marcstaiger/FPGA_Signalgenerator/Dokumentation/01_titel.tex

\begin{titlepage}
\begin{center}
\begin{tabular}{p{\textwidth}}

\begin{center}
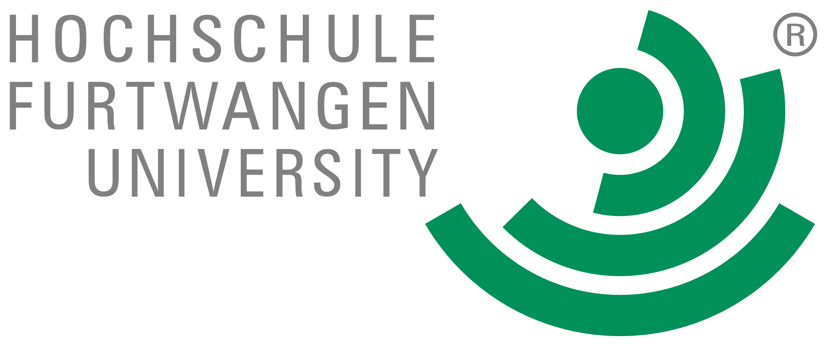
[picture p1: Dokumentation/Bilder/logo_hochschule.jpg]
    
\end{center}

\vspace{2cm}

\begin{center}
\LARGE{\textsc{
FPGA Praktikum \\
SoSe 26\\
\vspace{1cm}
 Aufgabe Signalgenerator
}}
\end{center}

\\

\begin{center}
\large{Fakultät 2 \\
der Hochschule Furtwangen }
\end{center}

\begin{center}
\large{im März 2026}
\end{center}

\\

\\
\
\begin{center}
\begin{tabular}{lll}
\textbf{Betreuer:} & & Prof. Dr. Richard Spiegelberg \\
\textbf{Autor:} & & Marc Staiger\\
\end{tabular}
\end{center}

\end{tabular}
\end{center}
\end{titlepage}
