marcstaiger/FPGA_Signalgenerator/Schaltplan.pdf

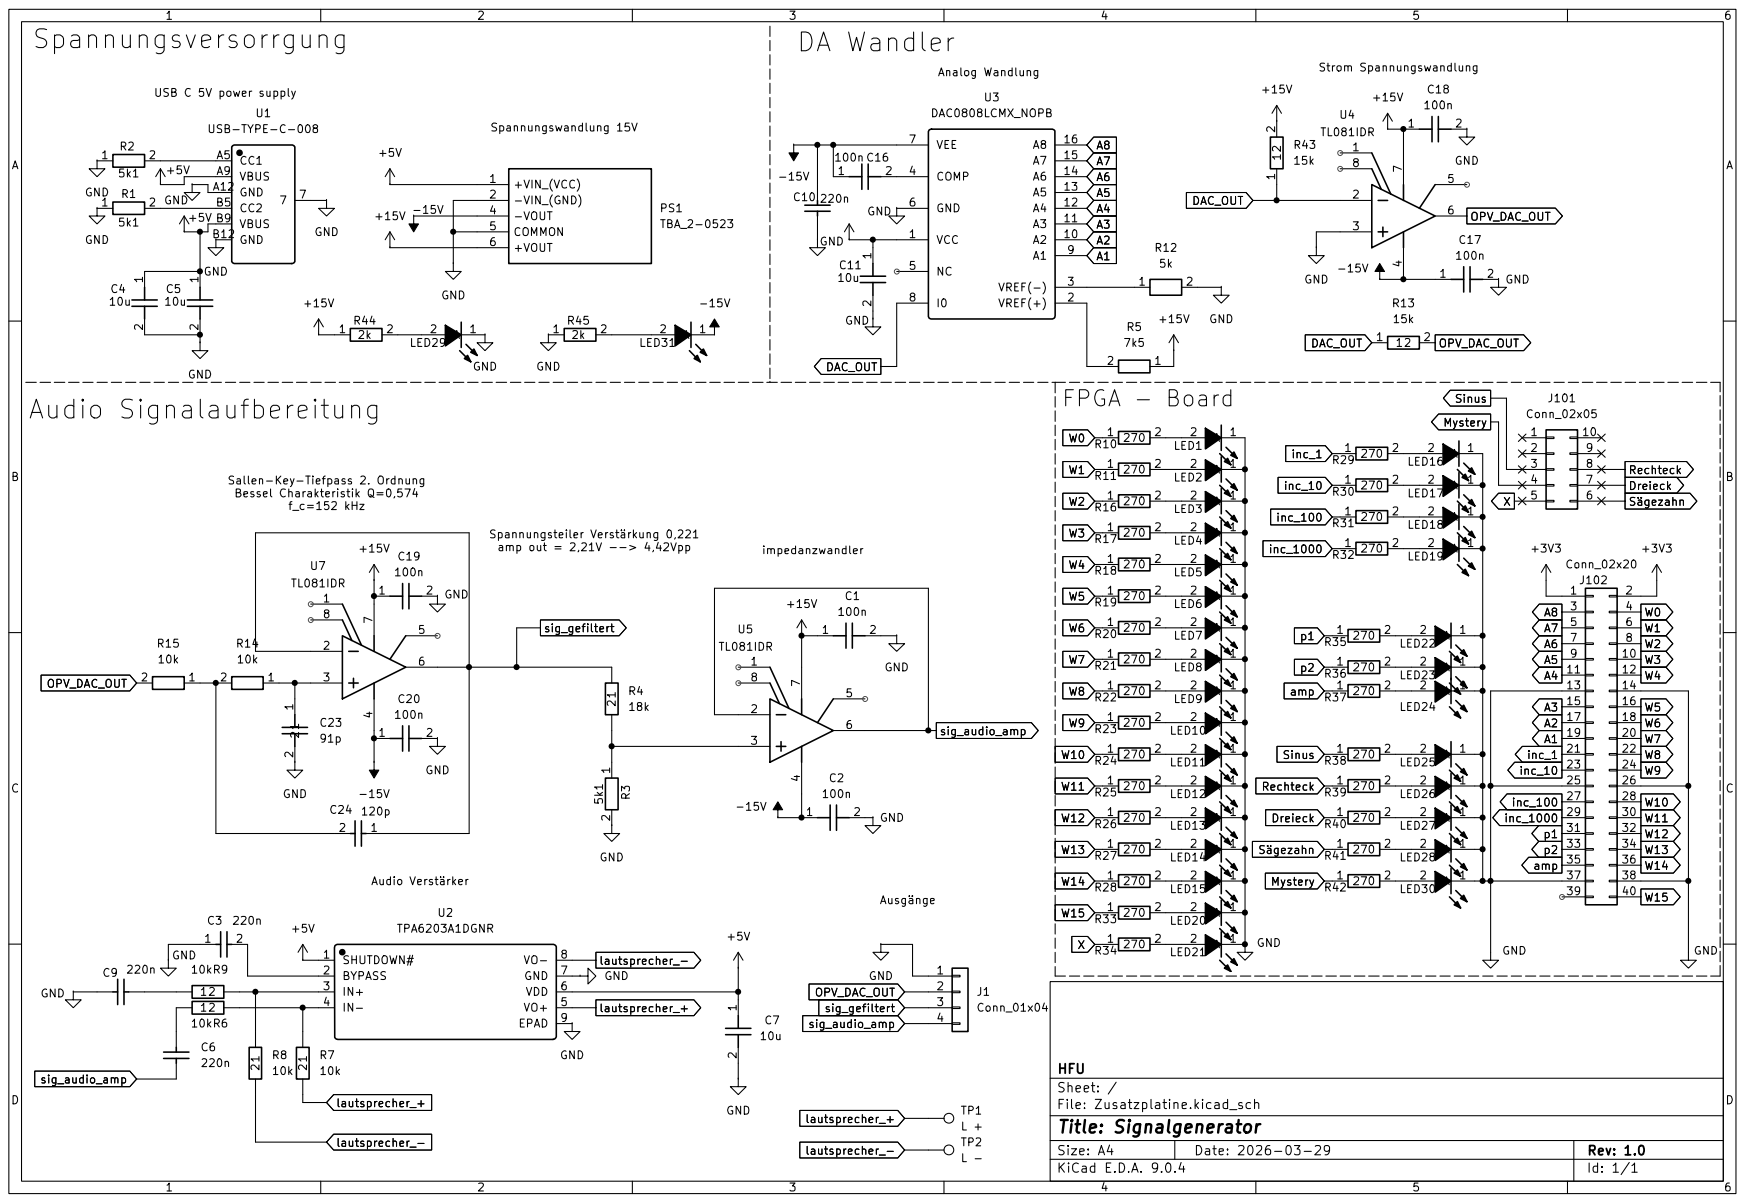
[picture p13: page 1]
