marcstaiger/FPGA_Signalgenerator/Platine/Platine.kicad_pcb

## KiCad design Platine/Platine.kicad_pcb (2026-09-23)

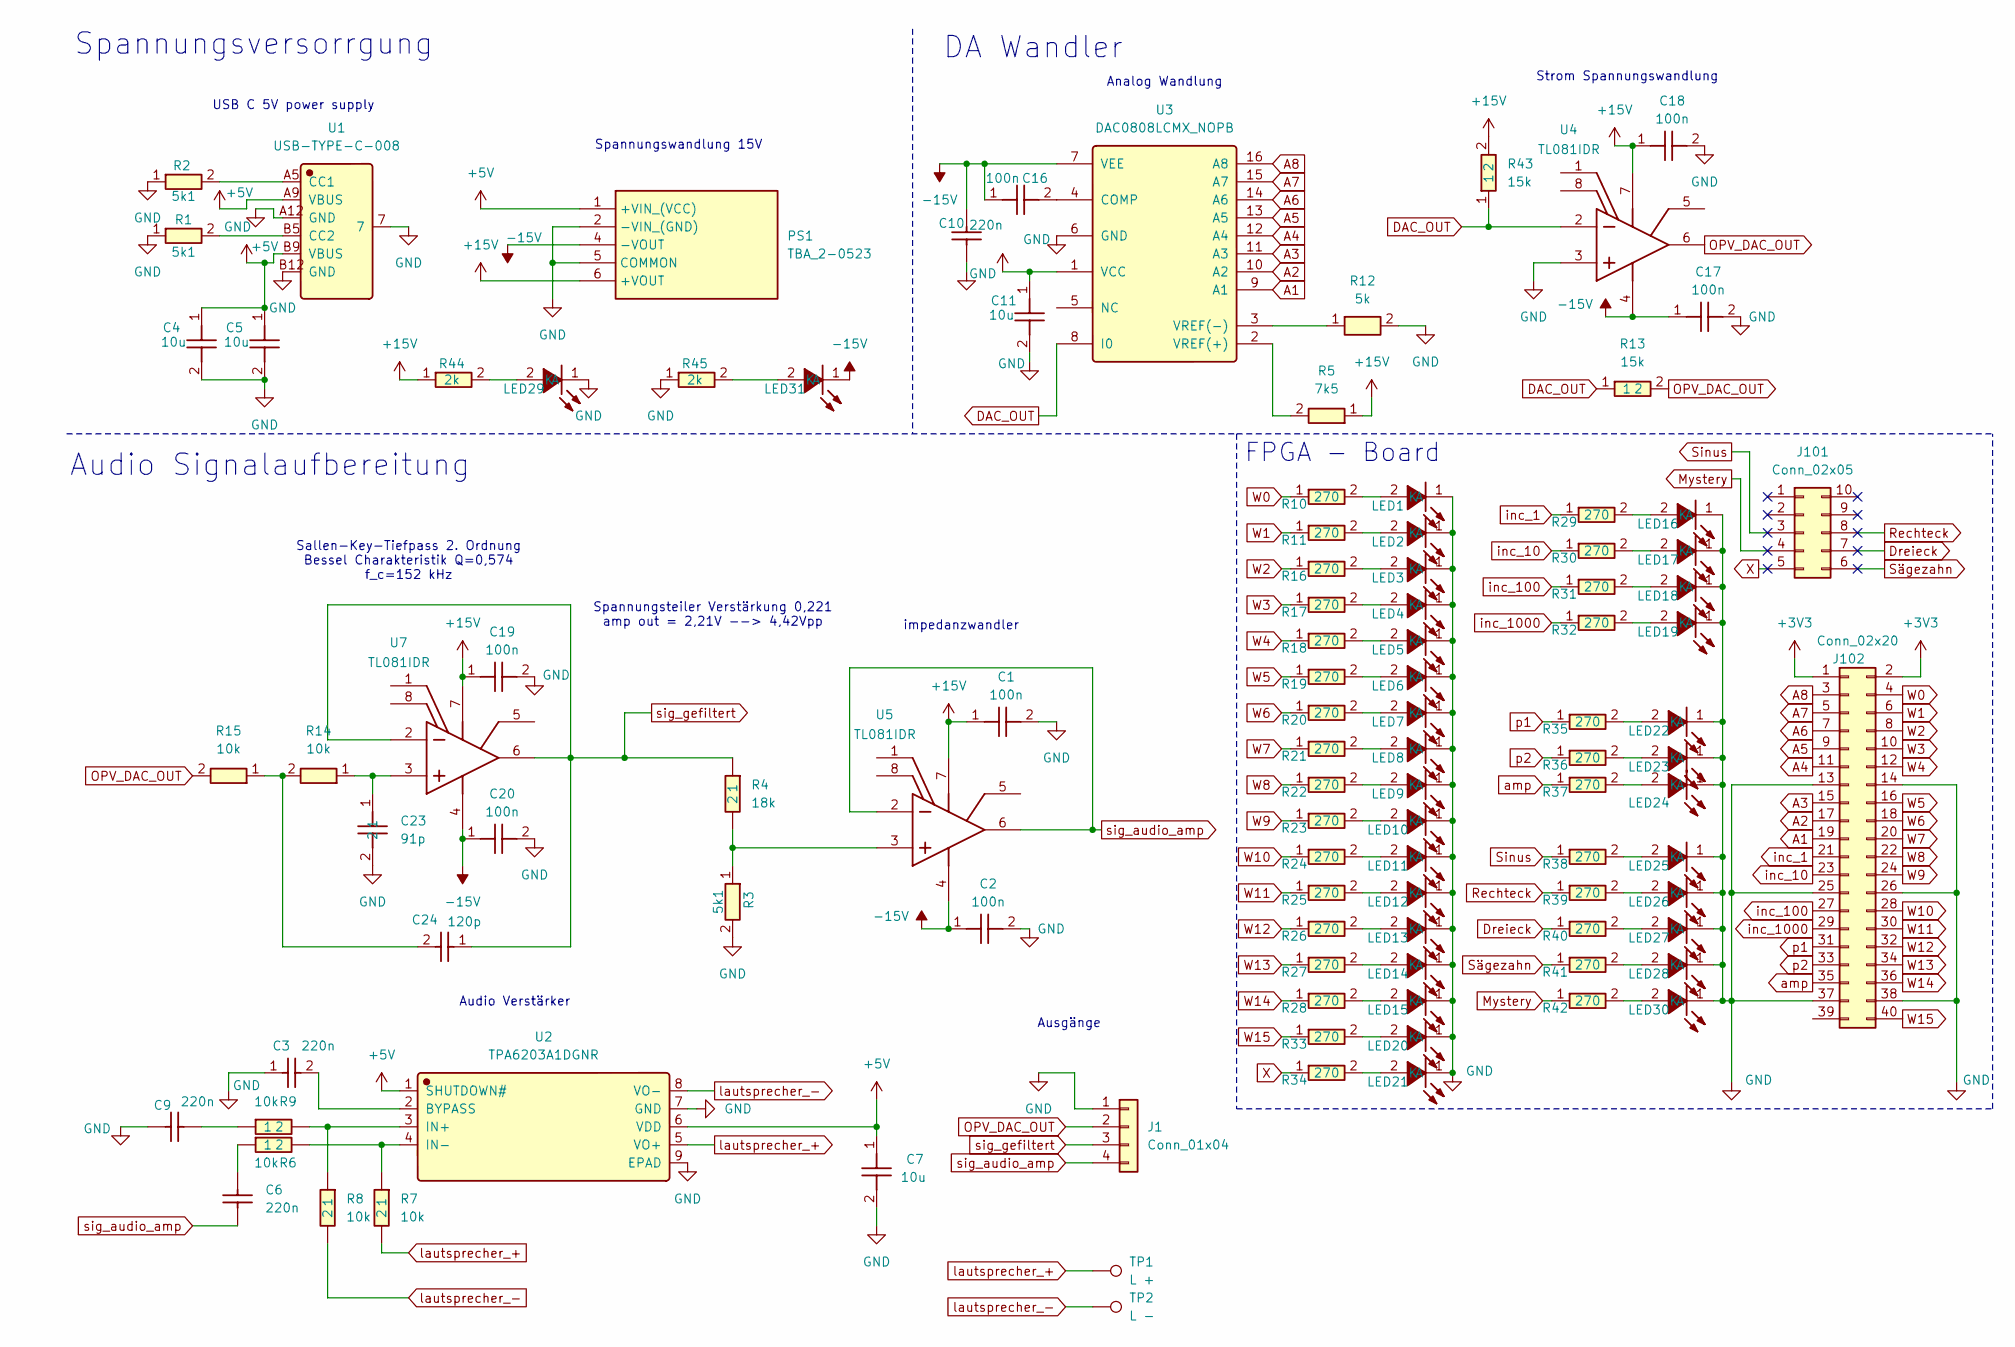
[picture p14: schematic Platine.kicad_sch, Signalgenerator]

Parts:
C1, C2, C16, C17, C18, C19, C20: 100n; CL05B104KO5NNNC; Manufacturer Part CL05B104KO5NNNC; LCSC C1525
C3, C6, C9, C10: 220n; CL21B224KBFNNNE; Manufacturer Part CL21B224KBFNNNE; LCSC C5378
C4, C5, C7, C11: 10u; CL21A106KAYNNNE; Manufacturer Part CL21A106KAYNNNE; LCSC C15850
C23: 91p; CC0402FRNPO9BN910; Manufacturer Part CC0402FRNPO9BN910; LCSC C541440
C24: 120p; GCM1555C1H121FA16D; Manufacturer Part GCM1555C1H121FA16D; LCSC C126496
J1: Conn_01x04; PinHeader_1x04_P2.54mm_Vertical
J101: Conn_02x05; PinHeader_2x05_P2.54mm_Vertical
J102: Conn_02x20; PinHeader_2x20_P2.54mm_Vertical
LED1: W0; KT-0603R; Manufacturer Part KT-0603R; LCSC C2286
LED2: W1; KT-0603R; Manufacturer Part KT-0603R; LCSC C2286
LED3: W2; KT-0603R; Manufacturer Part KT-0603R; LCSC C2286
LED4: W3; KT-0603R; Manufacturer Part KT-0603R; LCSC C2286
LED5: W4; KT-0603R; Manufacturer Part KT-0603R; LCSC C2286
LED6: W5; KT-0603R; Manufacturer Part KT-0603R; LCSC C2286
LED7: W6; KT-0603R; Manufacturer Part KT-0603R; LCSC C2286
LED8: W7; KT-0603R; Manufacturer Part KT-0603R; LCSC C2286
LED9: W8; KT-0603R; Manufacturer Part KT-0603R; LCSC C2286
LED10: W9; KT-0603R; Manufacturer Part KT-0603R; LCSC C2286
LED11: W10; KT-0603R; Manufacturer Part KT-0603R; LCSC C2286
LED12: W11; KT-0603R; Manufacturer Part KT-0603R; LCSC C2286
LED13: W12; KT-0603R; Manufacturer Part KT-0603R; LCSC C2286
LED14: W13; KT-0603R; Manufacturer Part KT-0603R; LCSC C2286
LED15: W14; KT-0603R; Manufacturer Part KT-0603R; LCSC C2286
LED16: inc_1; KT-0603R; Manufacturer Part KT-0603R; LCSC C2286
LED17: inc_10; KT-0603R; Manufacturer Part KT-0603R; LCSC C2286
LED18: inc_100; KT-0603R; Manufacturer Part KT-0603R; LCSC C2286
LED19: inc_1000; KT-0603R; Manufacturer Part KT-0603R; LCSC C2286
LED20: W15; KT-0603R; Manufacturer Part KT-0603R; LCSC C2286
LED21: X; KT-0603R; Manufacturer Part KT-0603R; LCSC C2286
LED22: p1; KT-0603R; Manufacturer Part KT-0603R; LCSC C2286
LED23: p2; KT-0603R; Manufacturer Part KT-0603R; LCSC C2286
LED24: amp; KT-0603R; Manufacturer Part KT-0603R; LCSC C2286
LED25: Sinus; KT-0603R; Manufacturer Part KT-0603R; LCSC C2286
LED26: Rechteck; KT-0603R; Manufacturer Part KT-0603R; LCSC C2286
LED27: Dreieck; KT-0603R; Manufacturer Part KT-0603R; LCSC C2286
LED28: Sägezahn; KT-0603R; Manufacturer Part KT-0603R; LCSC C2286
LED29: 15V; KT-0603R; Manufacturer Part KT-0603R; LCSC C2286
LED30: Mystery; KT-0603R; Manufacturer Part KT-0603R; LCSC C2286
LED31: -15V; KT-0603R; Manufacturer Part KT-0603R; LCSC C2286
PS1: TBA_2-0523; TBA20523; Manufacturer_Part_Number TBA 2-0523; LCSC C6547460
R1, R2, R3: 5k1; 0603WAF5101T5E; Manufacturer Part 0603WAF5101T5E; LCSC C23186
R4: 18k; 0603WAF1802T5E; Manufacturer Part 0603WAF1802T5E; LCSC C25810
R5: 7k5; 0603WAF7501T5E; Manufacturer Part 0603WAF7501T5E; LCSC C23234
R6, R7, R8, R9, R14, R15: 10k; 0603WAF1002T5E; Manufacturer Part 0603WAF1002T5E; LCSC C25804
R10: 270; RCT03270RJLF; Manufacturer Part RCT03270RJLF; LCSC C22966
R11, R16, R17, R18, R19, R20, R21, R22, R23, R24, R25, R26, R27, R28, R29, R30, R31, R32, R33, R34, R35, R36, R37, R38, R39, R40, R41, R42: 270; RCT03270RJLF; Manufacturer Part RCT03270RJLF; LCSC C177305
R12: 5k; P2TC0603D5001LNTA; Manufacturer Part P2TC0603D5001LNTA; LCSC C4095957
R13, R43: 15k; 0603WAF1502T5E; Manufacturer Part 0603WAF1502T5E; LCSC C22809
R44, R45: 2k; 0805W8F2001T5E; Manufacturer Part 0805W8F2001T5E; LCSC C17604
TP1: L +; Pin_D1.2mm_L11.3mm_W3.0mm_Flat
TP2: L -; Pin_D1.2mm_L11.3mm_W3.0mm_Flat
U1: USB-TYPE-C-008; Manufacturer Part USB-TYPE-C-008; LCSC C2927028
U2: TPA6203A1DGNR; Manufacturer Part TPA6203A1DGNR; LCSC C202146
U3: DAC0808LCMX_NOPB; Manufacturer Part DAC0808LCMX/NOPB; LCSC C132006
U4, U5, U7: TL081IDR; Manufacturer Part TL081IDR; LCSC C2057919

Connections:
+3V3: J102.1, J102.2
+5V: C4.1, C5.1, C7.1, C11.1, PS1.1 (+VIN_(VCC)), U1.A9 (VBUS), U1.B9 (VBUS), U2.1 (SHUTDOWN#), U2.6 (VDD), U3.1 (VCC)
+15V: C1.1, C18.1, C19.1, PS1.6 (+VOUT), R5.1, R43.2, R44.1, U4.7 (VCC+), U5.7 (VCC+), U7.7 (VCC+)
-15V: C2.1, C10.2, C16.1, C17.1, C20.1, LED31.1 (K), PS1.4 (-VOUT), U3.7 (VEE), U4.4 (VCC-), U5.4 (VCC-), U7.4 (VCC-)
A1: J102.19, U3.9 (A1)
A2: J102.17, U3.10 (A2)
A3: J102.15, U3.11 (A3)
A4: J102.11, U3.12 (A4)
A5: J102.9, U3.13 (A5)
A6: J102.7, U3.14 (A6)
A7: J102.5, U3.15 (A7)
A8: J102.3, U3.16 (A8)
DAC_OUT: R13.1, R43.1, U3.8 (I0), U4.2 (IN-)
Dreieck: J101.7, R40.1
GND: C1.2, C2.2, C3.1, C4.2, C5.2, C7.2, C9.2, C10.1, C11.2, C17.2, C18.2, C19.2, C20.2, C23.2, J1.1, J102.13, J102.14, J102.25, J102.26, J102.37, J102.38, LED1.1 (K), LED2.1 (K), LED3.1 (K), LED4.1 (K), LED5.1 (K), LED6.1 (K), LED7.1 (K), LED8.1 (K), LED9.1 (K), LED10.1 (K), LED11.1 (K), LED12.1 (K), LED13.1 (K), LED14.1 (K), LED15.1 (K), LED16.1 (K), LED17.1 (K), LED18.1 (K), LED19.1 (K), LED20.1 (K), LED21.1 (K), LED22.1 (K), LED23.1 (K), LED24.1 (K), LED25.1 (K), LED26.1 (K), LED27.1 (K), LED28.1 (K), LED29.1 (K), LED30.1 (K), PS1.2 (-VIN_(GND)), PS1.5 (COMMON), R1.1, R2.1, R3.2, R12.2, R45.1, U1.7, U1.A12 (GND), U1.B12 (GND), U2.7 (GND), U2.9 (EPAD), U3.6 (GND), U4.3 (IN+)
Mystery: J101.4, R42.1
unnamed: C6.2, R6.1
unnamed: C9.1, R9.1
unnamed: C24.2, R14.2, R15.1
unnamed: LED1.2 (A), R10.2
unnamed: LED2.2 (A), R11.2
unnamed: LED3.2 (A), R16.2
unnamed: LED4.2 (A), R17.2
unnamed: LED5.2 (A), R18.2
unnamed: LED6.2 (A), R19.2
unnamed: LED7.2 (A), R20.2
unnamed: LED8.2 (A), R21.2
unnamed: LED9.2 (A), R22.2
unnamed: LED10.2 (A), R23.2
unnamed: LED11.2 (A), R24.2
unnamed: LED12.2 (A), R25.2
unnamed: LED13.2 (A), R26.2
unnamed: LED14.2 (A), R27.2
unnamed: LED15.2 (A), R28.2
unnamed: LED16.2 (A), R29.2
unnamed: LED17.2 (A), R30.2
unnamed: LED18.2 (A), R31.2
unnamed: LED19.2 (A), R32.2
unnamed: LED20.2 (A), R33.2
unnamed: LED21.2 (A), R34.2
unnamed: LED22.2 (A), R35.2
unnamed: LED23.2 (A), R36.2
unnamed: LED24.2 (A), R37.2
unnamed: LED25.2 (A), R38.2
unnamed: LED26.2 (A), R39.2
unnamed: LED27.2 (A), R40.2
unnamed: LED28.2 (A), R41.2
unnamed: LED29.2 (A), R44.2
unnamed: LED30.2 (A), R42.2
unnamed: LED31.2 (A), R45.2
unnamed: R2.2, U1.A5 (CC1)
unnamed: R1.2, U1.B5 (CC2)
unnamed: C3.2, U2.2 (BYPASS)
unnamed: R8.1, R9.2, U2.3 (IN+)
unnamed: R6.2, R7.1, U2.4 (IN-)
unnamed: C16.2, U3.4 (COMP)
unnamed: R5.2, U3.2 (VREF(+))
unnamed: R12.1, U3.3 (VREF(-))
unnamed: R3.1, R4.2, U5.3 (IN+)
unnamed: C23.1, R14.1, U7.3 (IN+)
OPV_DAC_OUT: J1.2, R13.2, R15.2, U4.6 (OUT)
Rechteck: J101.8, R39.1
Sinus: J101.3, R38.1
Sägezahn: J101.6, R41.1
W0: J102.4, R10.1
W1: J102.6, R11.1
W2: J102.8, R16.1
W3: J102.10, R17.1
W4: J102.12, R18.1
W5: J102.16, R19.1
W6: J102.18, R20.1
W7: J102.20, R21.1
W8: J102.22, R22.1
W9: J102.24, R23.1
W10: J102.28, R24.1
W11: J102.30, R25.1
W12: J102.32, R26.1
W13: J102.34, R27.1
W14: J102.36, R28.1
W15: J102.40, R33.1
X: J101.5, R34.1
amp: J102.35, R37.1
inc_1: J102.21, R29.1
inc_10: J102.23, R30.1
inc_100: J102.27, R31.1
inc_1000: J102.29, R32.1
lautsprecher_+: R7.2, TP1.1, U2.5 (VO+)
lautsprecher_-: R8.2, TP2.1, U2.8 (VO-)
p1: J102.31, R35.1
p2: J102.33, R36.1
sig_audio_amp: C6.1, J1.4, U5.2 (IN-), U5.6 (OUT)
sig_gefiltert: C24.1, J1.3, R4.1, U7.2 (IN-), U7.6 (OUT)

Notes on the sheet:
Audio Signalaufbereitung
Audio Verstärker
Spannungsversorrgung
Ausgänge
Spannungsteiler Verstärkung 0,221 amp out = 2,21V --> 4,42Vpp
Spannungswandlung 15V
Analog Wandlung
FPGA - Board
Sallen-Key-Tiefpass 2. Ordnung Bessel Charakteristik Q=0,574 f_c=152 kHz
Strom Spannungswandlung
DA Wandler
USB C 5V power supply
impedanzwandler

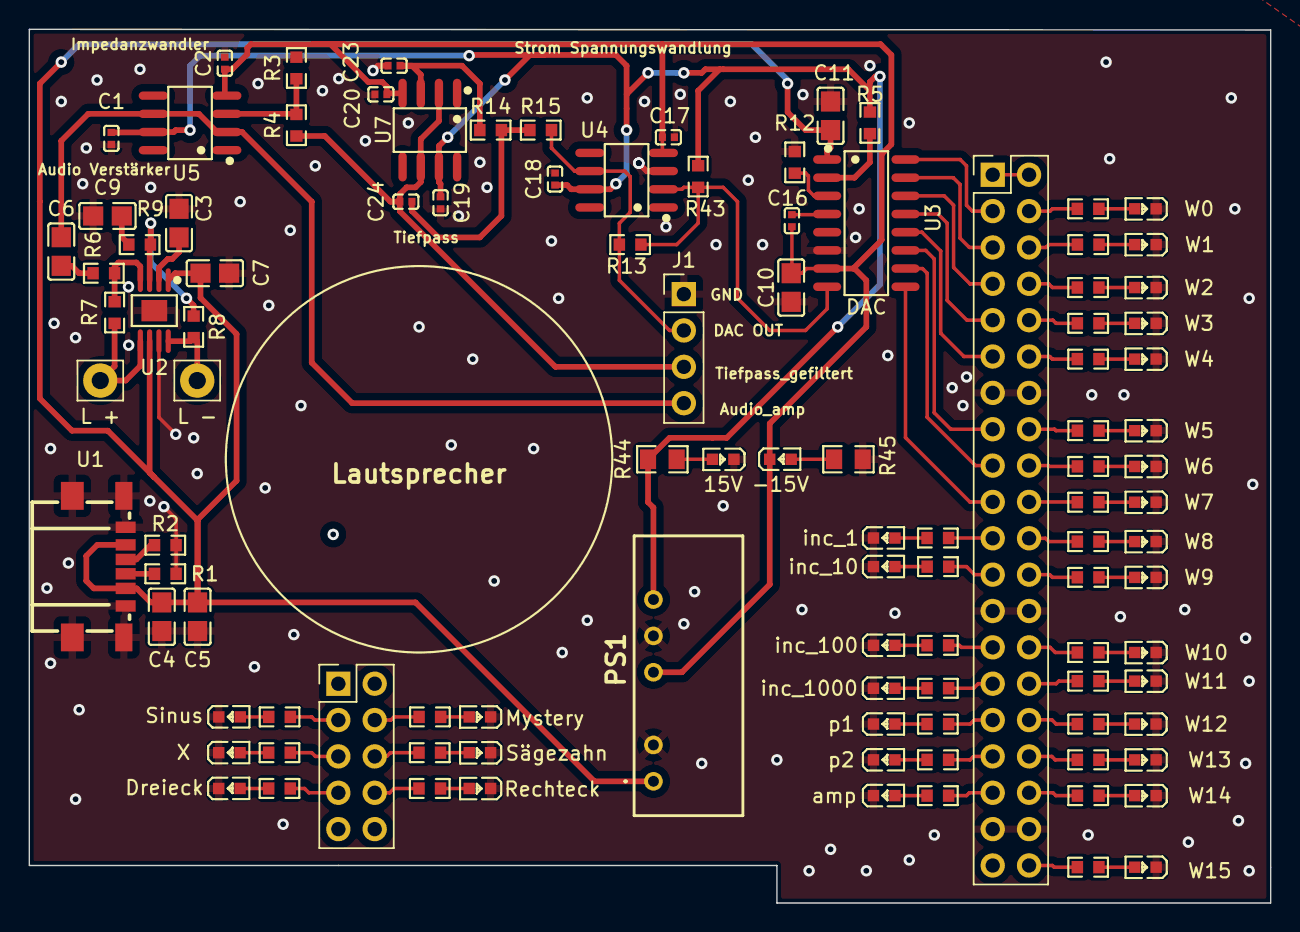
[picture p15: board Platine.kicad_pcb from above]

Board: 2 copper layers, 86.7 x 61.0 mm, 106 parts (0 on the bottom side), 92 nets.

Other parts of the board:
Ge: LOGO; HFU-9mm
