marcstaiger/FPGA_Signalgenerator/Code_Aufgabe/impl1/Toplevel_prim.v

// Verilog netlist produced by program LSE :  version Diamond (64-bit) 3.14.0.75.2
// Netlist written on Wed Sep 23 08:38:28 2026
//
// Verilog Description of module Toplevel
//

module Toplevel (clk, btn_mode, btn_param, btn_inc, btn_plus, btn_minus, 
            led_param, led_W, led_Modus, led_inc, A1, A2, A3, 
            A4, A5, A6, A7, A8, led1, led2, led3, led4, led5, 
            led6, led7, led8);   // c:/users/staig/documents/uni/master/signalgenerator/fpga_signalgenerator/code_loesung/toplevel.vhd(18[8:16])
    input clk;   // c:/users/staig/documents/uni/master/signalgenerator/fpga_signalgenerator/code_loesung/toplevel.vhd(20[9:12])
    input btn_mode;   // c:/users/staig/documents/uni/master/signalgenerator/fpga_signalgenerator/code_loesung/toplevel.vhd(23[9:17])
    input btn_param;   // c:/users/staig/documents/uni/master/signalgenerator/fpga_signalgenerator/code_loesung/toplevel.vhd(24[9:18])
    input btn_inc;   // c:/users/staig/documents/uni/master/signalgenerator/fpga_signalgenerator/code_loesung/toplevel.vhd(25[9:16])
    input btn_plus;   // c:/users/staig/documents/uni/master/signalgenerator/fpga_signalgenerator/code_loesung/toplevel.vhd(26[9:17])
    input btn_minus;   // c:/users/staig/documents/uni/master/signalgenerator/fpga_signalgenerator/code_loesung/toplevel.vhd(27[9:18])
    output [2:0]led_param;   // c:/users/staig/documents/uni/master/signalgenerator/fpga_signalgenerator/code_loesung/toplevel.vhd(30[9:18])
    output [15:0]led_W;   // c:/users/staig/documents/uni/master/signalgenerator/fpga_signalgenerator/code_loesung/toplevel.vhd(31[9:14])
    output [5:0]led_Modus;   // c:/users/staig/documents/uni/master/signalgenerator/fpga_signalgenerator/code_loesung/toplevel.vhd(32[9:18])
    output [3:0]led_inc;   // c:/users/staig/documents/uni/master/signalgenerator/fpga_signalgenerator/code_loesung/toplevel.vhd(33[9:16])
    output A1;   // c:/users/staig/documents/uni/master/signalgenerator/fpga_signalgenerator/code_loesung/toplevel.vhd(37[9:11])
    output A2;   // c:/users/staig/documents/uni/master/signalgenerator/fpga_signalgenerator/code_loesung/toplevel.vhd(38[9:11])
    output A3;   // c:/users/staig/documents/uni/master/signalgenerator/fpga_signalgenerator/code_loesung/toplevel.vhd(39[9:11])
    output A4;   // c:/users/staig/documents/uni/master/signalgenerator/fpga_signalgenerator/code_loesung/toplevel.vhd(40[9:11])
    output A5;   // c:/users/staig/documents/uni/master/signalgenerator/fpga_signalgenerator/code_loesung/toplevel.vhd(41[9:11])
    output A6;   // c:/users/staig/documents/uni/master/signalgenerator/fpga_signalgenerator/code_loesung/toplevel.vhd(42[9:11])
    output A7;   // c:/users/staig/documents/uni/master/signalgenerator/fpga_signalgenerator/code_loesung/toplevel.vhd(43[9:11])
    output A8;   // c:/users/staig/documents/uni/master/signalgenerator/fpga_signalgenerator/code_loesung/toplevel.vhd(44[9:11])
    output led1;   // c:/users/staig/documents/uni/master/signalgenerator/fpga_signalgenerator/code_loesung/toplevel.vhd(48[9:13])
    output led2;   // c:/users/staig/documents/uni/master/signalgenerator/fpga_signalgenerator/code_loesung/toplevel.vhd(49[9:13])
    output led3;   // c:/users/staig/documents/uni/master/signalgenerator/fpga_signalgenerator/code_loesung/toplevel.vhd(50[9:13])
    output led4;   // c:/users/staig/documents/uni/master/signalgenerator/fpga_signalgenerator/code_loesung/toplevel.vhd(51[9:13])
    output led5;   // c:/users/staig/documents/uni/master/signalgenerator/fpga_signalgenerator/code_loesung/toplevel.vhd(52[9:13])
    output led6;   // c:/users/staig/documents/uni/master/signalgenerator/fpga_signalgenerator/code_loesung/toplevel.vhd(53[9:13])
    output led7;   // c:/users/staig/documents/uni/master/signalgenerator/fpga_signalgenerator/code_loesung/toplevel.vhd(54[9:13])
    output led8;   // c:/users/staig/documents/uni/master/signalgenerator/fpga_signalgenerator/code_loesung/toplevel.vhd(55[9:13])
    
    wire clk_c /* synthesis SET_AS_NETWORK=clk_c, is_clock=1 */ ;   // c:/users/staig/documents/uni/master/signalgenerator/fpga_signalgenerator/code_loesung/toplevel.vhd(20[9:12])
    
    wire GND_net, VCC_net, btn_mode_c, btn_param_c, btn_inc_c, btn_plus_c, 
        btn_minus_c, led_param_c_2, led_param_c_1, led_param_c_0, led_W_c_15, 
        led_W_c_14, led_W_c_13, led_W_c_12, led_W_c_11, led_W_c_10, 
        led_W_c_9, led_W_c_8, led_W_c_7, led_W_c_6, led_W_c_5, led_W_c_4, 
        led_W_c_3, led_W_c_2, led_W_c_1, led_W_c_0, led_Modus_c_5, 
        led_Modus_c_4, led_Modus_c_3, led_Modus_c_2, led_Modus_c_1, 
        led_Modus_c_0, led_inc_c_3, led_inc_c_2, led_inc_c_1, led_inc_c_0, 
        led1_c, led2_c, led3_c, led4_c, led5_c, led6_c, led7_c, 
        led8_c, tick_en;
    wire [2:0]sig_mode;   // c:/users/staig/documents/uni/master/signalgenerator/fpga_signalgenerator/code_loesung/toplevel.vhd(70[12:20])
    wire [7:0]sig_amp;   // c:/users/staig/documents/uni/master/signalgenerator/fpga_signalgenerator/code_loesung/toplevel.vhd(71[12:19])
    wire [15:0]sig_p1;   // c:/users/staig/documents/uni/master/signalgenerator/fpga_signalgenerator/code_loesung/toplevel.vhd(72[12:18])
    wire [15:0]sig_p2;   // c:/users/staig/documents/uni/master/signalgenerator/fpga_signalgenerator/code_loesung/toplevel.vhd(73[12:18])
    wire [7:0]wave_rect;   // c:/users/staig/documents/uni/master/signalgenerator/fpga_signalgenerator/code_loesung/toplevel.vhd(76[12:21])
    wire [7:0]wave_tri;   // c:/users/staig/documents/uni/master/signalgenerator/fpga_signalgenerator/code_loesung/toplevel.vhd(77[12:20])
    wire [7:0]wave_sin;   // c:/users/staig/documents/uni/master/signalgenerator/fpga_signalgenerator/code_loesung/toplevel.vhd(78[12:20])
    wire [7:0]wave_saw;   // c:/users/staig/documents/uni/master/signalgenerator/fpga_signalgenerator/code_loesung/toplevel.vhd(79[12:20])
    wire [7:0]wave_mystery;   // c:/users/staig/documents/uni/master/signalgenerator/fpga_signalgenerator/code_loesung/toplevel.vhd(80[12:24])
    wire [15:0]led_W_normal;   // c:/users/staig/documents/uni/master/signalgenerator/fpga_signalgenerator/code_loesung/toplevel.vhd(95[12:24])
    
    wire n2680;
    wire [15:0]inc_val_reg;   // c:/users/staig/documents/uni/master/signalgenerator/fpga_signalgenerator/code_loesung/steuerung.vhd(45[12:23])
    wire [1:0]param_sel_reg;   // c:/users/staig/documents/uni/master/signalgenerator/fpga_signalgenerator/code_loesung/steuerung.vhd(44[12:25])
    
    wire sw2_clean, sw3_clean, sw4_clean, sw5_clean, sw6_clean;
    wire [15:0]inc_val_reg_15__N_131;
    
    wire n4;
    wire [15:0]led_W_out_15__N_70;
    
    wire flag_inc_status_3__N_98, flag_inc_status_3__N_238;
    wire [3:0]flag_inc_status_3__N_234;
    
    wire n6, is_rising, n3648, n14, n6137;
    wire [6:0]note_index;   // c:/users/staig/documents/uni/master/signalgenerator/fpga_signalgenerator/code_loesung/mystery.vhd(133[12:22])
    
    wire clk_c_enable_104, sync1, btn_clean_N_289, sync1_adj_666, btn_clean_N_289_adj_667, 
        n2678, sync1_adj_668, btn_clean_N_289_adj_669, sync1_adj_670, 
        btn_clean_N_289_adj_671, sync1_adj_672, btn_clean_N_289_adj_673, 
        n2676, n4_adj_674, n6_adj_675, n4_adj_676, n6_adj_677, n4_adj_678, 
        n6_adj_679, n2674, n4_adj_680, n6_adj_681, n2672, n2684, 
        n2670, n6_adj_682, n4_adj_683, n6_adj_684, n4_adj_685, n2682, 
        n5349, n5791, n5335, n6_adj_686, n4_adj_687, n6310, n5789, 
        n5788, n5787, n5786, n5785, n6133, n5882, n5784, n6128, 
        n6149, n6147;
    
    VHI i2 (.Z(VCC_net));
    saegezahn_gen gen_saw (.wave_saw({wave_saw}), .\sig_amp[7] (sig_amp[7]), 
            .\sig_amp[6] (sig_amp[6]), .\sig_amp[5] (sig_amp[5]), .\sig_amp[4] (sig_amp[4]), 
            .\sig_amp[3] (sig_amp[3]), .clk_c(clk_c), .\sig_amp[2] (sig_amp[2]), 
            .sig_p1({sig_p1}), .GND_net(GND_net), .VCC_net(VCC_net), .clk_c_enable_104(clk_c_enable_104), 
            .\sig_amp[1] (sig_amp[1]), .n6310(n6310));   // c:/users/staig/documents/uni/master/signalgenerator/fpga_signalgenerator/code_loesung/toplevel.vhd(201[15:40])
    ORCALUT4 i2086_4_lut (.A(wave_sin[0]), .B(sig_mode[0]), .C(wave_tri[0]), 
            .D(sig_mode[1]), .Z(n2670)) /* synthesis lut_function=(A (B (C+!(D)))+!A (B (C (D)))) */ ;   // c:/users/staig/documents/uni/master/signalgenerator/fpga_signalgenerator/code_loesung/toplevel.vhd(221[5] 228[50])
    defparam i2086_4_lut.init = 16'hc088;
    ORCALUT4 led_W_out_15__I_0_i8_3_lut_4_lut (.A(sig_mode[1]), .B(n6133), 
            .C(n6137), .D(sig_p1[7]), .Z(led_W_normal[7])) /* synthesis lut_function=(A (B (D)+!B (C))+!A (D)) */ ;   // c:/users/staig/documents/uni/master/signalgenerator/fpga_signalgenerator/code_loesung/toplevel.vhd(158[39:55])
    defparam led_W_out_15__I_0_i8_3_lut_4_lut.init = 16'hfd20;
    OB led_W_pad_4 (.I(led_W_c_4), .O(led_W[4]));   // c:/users/staig/documents/uni/master/signalgenerator/fpga_signalgenerator/code_loesung/toplevel.vhd(31[9:14])
    ORCALUT4 i2084_4_lut (.A(wave_sin[1]), .B(sig_mode[0]), .C(wave_tri[1]), 
            .D(sig_mode[1]), .Z(n2672)) /* synthesis lut_function=(A (B (C+!(D)))+!A (B (C (D)))) */ ;   // c:/users/staig/documents/uni/master/signalgenerator/fpga_signalgenerator/code_loesung/toplevel.vhd(221[5] 228[50])
    defparam i2084_4_lut.init = 16'hc088;
    ORCALUT4 i2092_4_lut (.A(wave_sin[6]), .B(sig_mode[0]), .C(wave_tri[6]), 
            .D(sig_mode[1]), .Z(n2682)) /* synthesis lut_function=(A (B (C+!(D)))+!A (B (C (D)))) */ ;   // c:/users/staig/documents/uni/master/signalgenerator/fpga_signalgenerator/code_loesung/toplevel.vhd(221[5] 228[50])
    defparam i2092_4_lut.init = 16'hc088;
    ORCALUT4 i4076_3_lut (.A(sw3_clean), .B(sync1_adj_666), .C(btn_clean_N_289_adj_667), 
            .Z(n5788)) /* synthesis lut_function=(A (B+!(C))+!A (B (C))) */ ;
    defparam i4076_3_lut.init = 16'hcaca;
    OB led_W_pad_5 (.I(led_W_c_5), .O(led_W[5]));   // c:/users/staig/documents/uni/master/signalgenerator/fpga_signalgenerator/code_loesung/toplevel.vhd(31[9:14])
    ORCALUT4 i1_4_lut (.A(n5335), .B(n5349), .C(inc_val_reg[5]), .D(inc_val_reg[2]), 
            .Z(flag_inc_status_3__N_234[2])) /* synthesis lut_function=(!(A+(B+!(C (D))))) */ ;
    defparam i1_4_lut.init = 16'h1000;
    OB led_W_pad_6 (.I(led_W_c_6), .O(led_W[6]));   // c:/users/staig/documents/uni/master/signalgenerator/fpga_signalgenerator/code_loesung/toplevel.vhd(31[9:14])
    ORCALUT4 i2091_4_lut (.A(wave_sin[7]), .B(sig_mode[0]), .C(wave_tri[7]), 
            .D(sig_mode[1]), .Z(n2684)) /* synthesis lut_function=(A (B (C+!(D)))+!A (B (C (D)))) */ ;   // c:/users/staig/documents/uni/master/signalgenerator/fpga_signalgenerator/code_loesung/toplevel.vhd(221[5] 228[50])
    defparam i2091_4_lut.init = 16'hc088;
    ORCALUT4 led_W_normal_15__I_0_i9_3_lut_4_lut (.A(sig_mode[1]), .B(n6133), 
            .C(led_W_normal[8]), .D(note_index[0]), .Z(led_W_c_8)) /* synthesis lut_function=(A (B (C)+!B !(D))+!A (C)) */ ;   // c:/users/staig/documents/uni/master/signalgenerator/fpga_signalgenerator/code_loesung/toplevel.vhd(158[39:55])
    defparam led_W_normal_15__I_0_i9_3_lut_4_lut.init = 16'hd0f2;
    ORCALUT4 i3644_2_lut (.A(inc_val_reg[0]), .B(inc_val_reg[9]), .Z(n5349)) /* synthesis lut_function=(A+(B)) */ ;
    defparam i3644_2_lut.init = 16'heeee;
    frequenzteiler freqteiler_inst (.sig_p2({sig_p2}), .GND_net(GND_net), 
            .VCC_net(VCC_net), .tick_en(tick_en), .clk_c(clk_c), .clk_c_enable_104(clk_c_enable_104), 
            .n6310(n6310));   // c:/users/staig/documents/uni/master/signalgenerator/fpga_signalgenerator/code_loesung/toplevel.vhd(163[23:49])
    ORCALUT4 led_W_out_15__I_0_i2_3_lut_4_lut (.A(sig_mode[1]), .B(n6133), 
            .C(n6137), .D(sig_p1[1]), .Z(led_W_normal[1])) /* synthesis lut_function=(A (B (D)+!B (C))+!A (D)) */ ;   // c:/users/staig/documents/uni/master/signalgenerator/fpga_signalgenerator/code_loesung/toplevel.vhd(158[39:55])
    defparam led_W_out_15__I_0_i2_3_lut_4_lut.init = 16'hfd20;
    OB led_W_pad_7 (.I(led_W_c_7), .O(led_W[7]));   // c:/users/staig/documents/uni/master/signalgenerator/fpga_signalgenerator/code_loesung/toplevel.vhd(31[9:14])
    OB led_W_pad_8 (.I(led_W_c_8), .O(led_W[8]));   // c:/users/staig/documents/uni/master/signalgenerator/fpga_signalgenerator/code_loesung/toplevel.vhd(31[9:14])
    OB led_W_pad_9 (.I(led_W_c_9), .O(led_W[9]));   // c:/users/staig/documents/uni/master/signalgenerator/fpga_signalgenerator/code_loesung/toplevel.vhd(31[9:14])
    OB led_W_pad_10 (.I(led_W_c_10), .O(led_W[10]));   // c:/users/staig/documents/uni/master/signalgenerator/fpga_signalgenerator/code_loesung/toplevel.vhd(31[9:14])
    OB led_W_pad_11 (.I(led_W_c_11), .O(led_W[11]));   // c:/users/staig/documents/uni/master/signalgenerator/fpga_signalgenerator/code_loesung/toplevel.vhd(31[9:14])
    OB led_W_pad_12 (.I(led_W_c_12), .O(led_W[12]));   // c:/users/staig/documents/uni/master/signalgenerator/fpga_signalgenerator/code_loesung/toplevel.vhd(31[9:14])
    OB led_W_pad_13 (.I(led_W_c_13), .O(led_W[13]));   // c:/users/staig/documents/uni/master/signalgenerator/fpga_signalgenerator/code_loesung/toplevel.vhd(31[9:14])
    OB led_W_pad_14 (.I(led_W_c_14), .O(led_W[14]));   // c:/users/staig/documents/uni/master/signalgenerator/fpga_signalgenerator/code_loesung/toplevel.vhd(31[9:14])
    OB led_W_pad_15 (.I(led_W_c_15), .O(led_W[15]));   // c:/users/staig/documents/uni/master/signalgenerator/fpga_signalgenerator/code_loesung/toplevel.vhd(31[9:14])
    OB led_param_pad_0 (.I(led_param_c_0), .O(led_param[0]));   // c:/users/staig/documents/uni/master/signalgenerator/fpga_signalgenerator/code_loesung/toplevel.vhd(30[9:18])
    OB led_param_pad_1 (.I(led_param_c_1), .O(led_param[1]));   // c:/users/staig/documents/uni/master/signalgenerator/fpga_signalgenerator/code_loesung/toplevel.vhd(30[9:18])
    OB led_param_pad_2 (.I(led_param_c_2), .O(led_param[2]));   // c:/users/staig/documents/uni/master/signalgenerator/fpga_signalgenerator/code_loesung/toplevel.vhd(30[9:18])
    ORCALUT4 sig_mode_2__I_0_Mux_0_i4_4_lut (.A(sig_amp[1]), .B(wave_saw[0]), 
            .C(sig_mode[0]), .D(wave_rect[7]), .Z(n4_adj_680)) /* synthesis lut_function=(A (B (C+(D))+!B !(C+!(D)))+!A (B (C+!(D))+!B !(C+(D)))) */ ;   // c:/users/staig/documents/uni/master/signalgenerator/fpga_signalgenerator/code_loesung/toplevel.vhd(221[5] 228[50])
    defparam sig_mode_2__I_0_Mux_0_i4_4_lut.init = 16'hcac5;
    ORCALUT4 led_W_normal_15__I_0_i12_3_lut_4_lut (.A(sig_mode[1]), .B(n6133), 
            .C(led_W_normal[11]), .D(n6137), .Z(led_W_c_11)) /* synthesis lut_function=(A (B (C)+!B (D))+!A (C)) */ ;   // c:/users/staig/documents/uni/master/signalgenerator/fpga_signalgenerator/code_loesung/toplevel.vhd(158[39:55])
    defparam led_W_normal_15__I_0_i12_3_lut_4_lut.init = 16'hf2d0;
    ORCALUT4 sig_mode_2__I_0_Mux_1_i4_4_lut (.A(sig_amp[2]), .B(wave_saw[1]), 
            .C(sig_mode[0]), .D(wave_rect[7]), .Z(n4_adj_678)) /* synthesis lut_function=(A (B (C+(D))+!B !(C+!(D)))+!A (B (C+!(D))+!B !(C+(D)))) */ ;   // c:/users/staig/documents/uni/master/signalgenerator/fpga_signalgenerator/code_loesung/toplevel.vhd(221[5] 228[50])
    defparam sig_mode_2__I_0_Mux_1_i4_4_lut.init = 16'hcac5;
    ORCALUT4 sig_mode_2__I_0_Mux_2_i4_4_lut (.A(sig_amp[3]), .B(wave_saw[2]), 
            .C(sig_mode[0]), .D(wave_rect[7]), .Z(n4_adj_676)) /* synthesis lut_function=(A (B (C+(D))+!B !(C+!(D)))+!A (B (C+!(D))+!B !(C+(D)))) */ ;   // c:/users/staig/documents/uni/master/signalgenerator/fpga_signalgenerator/code_loesung/toplevel.vhd(221[5] 228[50])
    defparam sig_mode_2__I_0_Mux_2_i4_4_lut.init = 16'hcac5;
    ORCALUT4 led_W_normal_15__I_0_i11_3_lut_4_lut (.A(sig_mode[1]), .B(n6133), 
            .C(led_W_normal[10]), .D(note_index[0]), .Z(led_W_c_10)) /* synthesis lut_function=(A (B (C)+!B !(D))+!A (C)) */ ;   // c:/users/staig/documents/uni/master/signalgenerator/fpga_signalgenerator/code_loesung/toplevel.vhd(158[39:55])
    defparam led_W_normal_15__I_0_i11_3_lut_4_lut.init = 16'hd0f2;
    ORCALUT4 i4077_4_lut_4_lut (.A(is_rising), .B(wave_tri[7]), .C(n3648), 
            .D(n14), .Z(n5789)) /* synthesis lut_function=(!(A (B (D))+!A (B+(C)))) */ ;
    defparam i4077_4_lut_4_lut.init = 16'h23ab;
    ORCALUT4 led_W_normal_15__I_0_i14_3_lut_4_lut (.A(sig_mode[1]), .B(n6133), 
            .C(led_W_normal[13]), .D(n6137), .Z(led_W_c_13)) /* synthesis lut_function=(A (B (C)+!B (D))+!A (C)) */ ;   // c:/users/staig/documents/uni/master/signalgenerator/fpga_signalgenerator/code_loesung/toplevel.vhd(158[39:55])
    defparam led_W_normal_15__I_0_i14_3_lut_4_lut.init = 16'hf2d0;
    ORCALUT4 sig_mode_2__I_0_Mux_3_i4_4_lut (.A(sig_amp[4]), .B(wave_saw[3]), 
            .C(sig_mode[0]), .D(wave_rect[7]), .Z(n4_adj_674)) /* synthesis lut_function=(A (B (C+(D))+!B !(C+!(D)))+!A (B (C+!(D))+!B !(C+(D)))) */ ;   // c:/users/staig/documents/uni/master/signalgenerator/fpga_signalgenerator/code_loesung/toplevel.vhd(221[5] 228[50])
    defparam sig_mode_2__I_0_Mux_3_i4_4_lut.init = 16'hcac5;
    ORCALUT4 led_W_normal_15__I_0_i15_3_lut_4_lut (.A(sig_mode[1]), .B(n6133), 
            .C(led_W_normal[14]), .D(note_index[0]), .Z(led_W_c_14)) /* synthesis lut_function=(A (B (C)+!B !(D))+!A (C)) */ ;   // c:/users/staig/documents/uni/master/signalgenerator/fpga_signalgenerator/code_loesung/toplevel.vhd(158[39:55])
    defparam led_W_normal_15__I_0_i15_3_lut_4_lut.init = 16'hd0f2;
    ORCALUT4 sig_mode_2__I_0_Mux_4_i4_4_lut (.A(sig_amp[5]), .B(wave_saw[4]), 
            .C(sig_mode[0]), .D(wave_rect[7]), .Z(n4)) /* synthesis lut_function=(A (B (C+(D))+!B !(C+!(D)))+!A (B (C+!(D))+!B !(C+(D)))) */ ;   // c:/users/staig/documents/uni/master/signalgenerator/fpga_signalgenerator/code_loesung/toplevel.vhd(221[5] 228[50])
    defparam sig_mode_2__I_0_Mux_4_i4_4_lut.init = 16'hcac5;
    ORCALUT4 i3630_2_lut (.A(inc_val_reg[1]), .B(inc_val_reg[3]), .Z(n5335)) /* synthesis lut_function=(A+(B)) */ ;
    defparam i3630_2_lut.init = 16'heeee;
    ORCALUT4 sig_mode_2__I_0_Mux_5_i4_4_lut (.A(sig_amp[6]), .B(wave_saw[5]), 
            .C(sig_mode[0]), .D(wave_rect[7]), .Z(n4_adj_683)) /* synthesis lut_function=(A (B (C+(D))+!B !(C+!(D)))+!A (B (C+!(D))+!B !(C+(D)))) */ ;   // c:/users/staig/documents/uni/master/signalgenerator/fpga_signalgenerator/code_loesung/toplevel.vhd(221[5] 228[50])
    defparam sig_mode_2__I_0_Mux_5_i4_4_lut.init = 16'hcac5;
    ORCALUT4 led_W_normal_15__I_0_i16_3_lut_4_lut (.A(sig_mode[1]), .B(n6133), 
            .C(led_W_normal[15]), .D(n6137), .Z(led_W_c_15)) /* synthesis lut_function=(A (B (C)+!B (D))+!A (C)) */ ;   // c:/users/staig/documents/uni/master/signalgenerator/fpga_signalgenerator/code_loesung/toplevel.vhd(158[39:55])
    defparam led_W_normal_15__I_0_i16_3_lut_4_lut.init = 16'hf2d0;
    ORCALUT4 i2083_4_lut (.A(wave_sin[2]), .B(sig_mode[0]), .C(wave_tri[2]), 
            .D(sig_mode[1]), .Z(n2674)) /* synthesis lut_function=(A (B (C+!(D)))+!A (B (C (D)))) */ ;   // c:/users/staig/documents/uni/master/signalgenerator/fpga_signalgenerator/code_loesung/toplevel.vhd(221[5] 228[50])
    defparam i2083_4_lut.init = 16'hc088;
    OB led_W_pad_3 (.I(led_W_c_3), .O(led_W[3]));   // c:/users/staig/documents/uni/master/signalgenerator/fpga_signalgenerator/code_loesung/toplevel.vhd(31[9:14])
    ORCALUT4 led_param_normal_2__I_0_i1_3_lut_4_lut (.A(sig_mode[1]), .B(n6133), 
            .C(n6147), .D(note_index[0]), .Z(led_param_c_0)) /* synthesis lut_function=(!(A (B (C)+!B (D))+!A (C))) */ ;   // c:/users/staig/documents/uni/master/signalgenerator/fpga_signalgenerator/code_loesung/toplevel.vhd(158[39:55])
    defparam led_param_normal_2__I_0_i1_3_lut_4_lut.init = 16'h0d2f;
    ORCALUT4 i4270_2_lut (.A(sig_mode[2]), .B(sig_mode[1]), .Z(n5882)) /* synthesis lut_function=((B)+!A) */ ;   // c:/users/staig/documents/uni/master/signalgenerator/fpga_signalgenerator/code_loesung/toplevel.vhd(221[5] 228[50])
    defparam i4270_2_lut.init = 16'hdddd;
    ORCALUT4 led_param_normal_2__I_0_i2_3_lut_4_lut (.A(sig_mode[1]), .B(n6133), 
            .C(n6149), .D(n6137), .Z(led_param_c_1)) /* synthesis lut_function=(!(A (B (C)+!B !(D))+!A (C))) */ ;   // c:/users/staig/documents/uni/master/signalgenerator/fpga_signalgenerator/code_loesung/toplevel.vhd(158[39:55])
    defparam led_param_normal_2__I_0_i2_3_lut_4_lut.init = 16'h2f0d;
    ORCALUT4 led_param_normal_2__I_0_i3_3_lut_4_lut (.A(sig_mode[1]), .B(n6133), 
            .C(param_sel_reg[1]), .D(note_index[0]), .Z(led_param_c_2)) /* synthesis lut_function=(A (B (C)+!B !(D))+!A (C)) */ ;   // c:/users/staig/documents/uni/master/signalgenerator/fpga_signalgenerator/code_loesung/toplevel.vhd(158[39:55])
    defparam led_param_normal_2__I_0_i3_3_lut_4_lut.init = 16'hd0f2;
    ORCALUT4 led_W_out_15__I_0_i3_3_lut_4_lut_4_lut (.A(note_index[0]), .B(sig_p1[2]), 
            .C(n6133), .D(sig_mode[1]), .Z(led_W_normal[2])) /* synthesis lut_function=(A (B (C+!(D)))+!A (B+!(C+!(D)))) */ ;   // c:/users/staig/documents/uni/master/signalgenerator/fpga_signalgenerator/code_loesung/toplevel.vhd(134[5] 138[47])
    defparam led_W_out_15__I_0_i3_3_lut_4_lut_4_lut.init = 16'hc5cc;
    ORCALUT4 led_W_out_15__I_0_i5_3_lut_4_lut_4_lut (.A(note_index[0]), .B(sig_p1[4]), 
            .C(n6133), .D(sig_mode[1]), .Z(led_W_normal[4])) /* synthesis lut_function=(A (B (C+!(D)))+!A (B+!(C+!(D)))) */ ;   // c:/users/staig/documents/uni/master/signalgenerator/fpga_signalgenerator/code_loesung/toplevel.vhd(134[5] 138[47])
    defparam led_W_out_15__I_0_i5_3_lut_4_lut_4_lut.init = 16'hc5cc;
    ORCALUT4 led_W_out_15__I_0_i1_3_lut_4_lut_4_lut (.A(note_index[0]), .B(sig_p1[0]), 
            .C(n6133), .D(sig_mode[1]), .Z(led_W_normal[0])) /* synthesis lut_function=(A (B (C+!(D)))+!A (B+!(C+!(D)))) */ ;   // c:/users/staig/documents/uni/master/signalgenerator/fpga_signalgenerator/code_loesung/toplevel.vhd(134[5] 138[47])
    defparam led_W_out_15__I_0_i1_3_lut_4_lut_4_lut.init = 16'hc5cc;
    ORCALUT4 led_W_out_15__I_0_i7_3_lut_4_lut_4_lut (.A(note_index[0]), .B(sig_p1[6]), 
            .C(n6133), .D(sig_mode[1]), .Z(led_W_normal[6])) /* synthesis lut_function=(A (B (C+!(D)))+!A (B+!(C+!(D)))) */ ;   // c:/users/staig/documents/uni/master/signalgenerator/fpga_signalgenerator/code_loesung/toplevel.vhd(134[5] 138[47])
    defparam led_W_out_15__I_0_i7_3_lut_4_lut_4_lut.init = 16'hc5cc;
    ORCALUT4 led_inc_normal_3__I_0_i1_3_lut_4_lut (.A(sig_mode[1]), .B(n6133), 
            .C(flag_inc_status_3__N_98), .D(note_index[0]), .Z(led_inc_c_0)) /* synthesis lut_function=(A (B (C)+!B !(D))+!A (C)) */ ;   // c:/users/staig/documents/uni/master/signalgenerator/fpga_signalgenerator/code_loesung/toplevel.vhd(158[39:55])
    defparam led_inc_normal_3__I_0_i1_3_lut_4_lut.init = 16'hd0f2;
    ORCALUT4 i2082_4_lut (.A(wave_sin[3]), .B(sig_mode[0]), .C(wave_tri[3]), 
            .D(sig_mode[1]), .Z(n2676)) /* synthesis lut_function=(A (B (C+!(D)))+!A (B (C (D)))) */ ;   // c:/users/staig/documents/uni/master/signalgenerator/fpga_signalgenerator/code_loesung/toplevel.vhd(221[5] 228[50])
    defparam i2082_4_lut.init = 16'hc088;
    ORCALUT4 sig_mode_2__I_0_Mux_6_i4_4_lut (.A(sig_amp[7]), .B(wave_saw[6]), 
            .C(sig_mode[0]), .D(wave_rect[7]), .Z(n4_adj_685)) /* synthesis lut_function=(A (B (C+(D))+!B !(C+!(D)))+!A (B (C+!(D))+!B !(C+(D)))) */ ;   // c:/users/staig/documents/uni/master/signalgenerator/fpga_signalgenerator/code_loesung/toplevel.vhd(221[5] 228[50])
    defparam sig_mode_2__I_0_Mux_6_i4_4_lut.init = 16'hcac5;
    ORCALUT4 sig_mode_2__I_0_Mux_7_i4_3_lut (.A(wave_rect[7]), .B(wave_saw[7]), 
            .C(sig_mode[0]), .Z(n4_adj_687)) /* synthesis lut_function=(A (B+!(C))+!A (B (C))) */ ;   // c:/users/staig/documents/uni/master/signalgenerator/fpga_signalgenerator/code_loesung/toplevel.vhd(221[5] 228[50])
    defparam sig_mode_2__I_0_Mux_7_i4_3_lut.init = 16'hcaca;
    ORCALUT4 led_inc_normal_3__I_0_i4_4_lut (.A(n6137), .B(flag_inc_status_3__N_238), 
            .C(n6128), .D(inc_val_reg_15__N_131[3]), .Z(led_inc_c_3)) /* synthesis lut_function=(A (B (C)+!B (C+!(D)))+!A !(B+(C+(D)))) */ ;   // c:/users/staig/documents/uni/master/signalgenerator/fpga_signalgenerator/code_loesung/toplevel.vhd(159[18:75])
    defparam led_inc_normal_3__I_0_i4_4_lut.init = 16'ha0a3;
    PFUMX led_W_normal_15__I_0_i2 (.BLUT(led_W_out_15__N_70[1]), .ALUT(led_W_normal[1]), 
          .C0(n5791), .Z(led_W_c_1));
    PFUMX sig_mode_2__I_0_Mux_7_i7 (.BLUT(n4_adj_687), .ALUT(n6_adj_686), 
          .C0(n5882), .Z(led1_c));
    GSR GSR_INST (.GSR(VCC_net));
    OB led_W_pad_2 (.I(led_W_c_2), .O(led_W[2]));   // c:/users/staig/documents/uni/master/signalgenerator/fpga_signalgenerator/code_loesung/toplevel.vhd(31[9:14])
    OB led_W_pad_1 (.I(led_W_c_1), .O(led_W[1]));   // c:/users/staig/documents/uni/master/signalgenerator/fpga_signalgenerator/code_loesung/toplevel.vhd(31[9:14])
    OB led_W_pad_0 (.I(led_W_c_0), .O(led_W[0]));   // c:/users/staig/documents/uni/master/signalgenerator/fpga_signalgenerator/code_loesung/toplevel.vhd(31[9:14])
    OB led_Modus_pad_5 (.I(led_Modus_c_5), .O(led_Modus[5]));   // c:/users/staig/documents/uni/master/signalgenerator/fpga_signalgenerator/code_loesung/toplevel.vhd(32[9:18])
    OB led_Modus_pad_4 (.I(led_Modus_c_4), .O(led_Modus[4]));   // c:/users/staig/documents/uni/master/signalgenerator/fpga_signalgenerator/code_loesung/toplevel.vhd(32[9:18])
    OB led_Modus_pad_3 (.I(led_Modus_c_3), .O(led_Modus[3]));   // c:/users/staig/documents/uni/master/signalgenerator/fpga_signalgenerator/code_loesung/toplevel.vhd(32[9:18])
    OB led_Modus_pad_2 (.I(led_Modus_c_2), .O(led_Modus[2]));   // c:/users/staig/documents/uni/master/signalgenerator/fpga_signalgenerator/code_loesung/toplevel.vhd(32[9:18])
    OB led_Modus_pad_1 (.I(led_Modus_c_1), .O(led_Modus[1]));   // c:/users/staig/documents/uni/master/signalgenerator/fpga_signalgenerator/code_loesung/toplevel.vhd(32[9:18])
    OB led_Modus_pad_0 (.I(led_Modus_c_0), .O(led_Modus[0]));   // c:/users/staig/documents/uni/master/signalgenerator/fpga_signalgenerator/code_loesung/toplevel.vhd(32[9:18])
    OB led_inc_pad_3 (.I(led_inc_c_3), .O(led_inc[3]));   // c:/users/staig/documents/uni/master/signalgenerator/fpga_signalgenerator/code_loesung/toplevel.vhd(33[9:16])
    OB led_inc_pad_2 (.I(led_inc_c_2), .O(led_inc[2]));   // c:/users/staig/documents/uni/master/signalgenerator/fpga_signalgenerator/code_loesung/toplevel.vhd(33[9:16])
    OB led_inc_pad_1 (.I(led_inc_c_1), .O(led_inc[1]));   // c:/users/staig/documents/uni/master/signalgenerator/fpga_signalgenerator/code_loesung/toplevel.vhd(33[9:16])
    OB led_inc_pad_0 (.I(led_inc_c_0), .O(led_inc[0]));   // c:/users/staig/documents/uni/master/signalgenerator/fpga_signalgenerator/code_loesung/toplevel.vhd(33[9:16])
    OB A1_pad (.I(led1_c), .O(A1));   // c:/users/staig/documents/uni/master/signalgenerator/fpga_signalgenerator/code_loesung/toplevel.vhd(37[9:11])
    OB A2_pad (.I(led2_c), .O(A2));   // c:/users/staig/documents/uni/master/signalgenerator/fpga_signalgenerator/code_loesung/toplevel.vhd(38[9:11])
    OB A3_pad (.I(led3_c), .O(A3));   // c:/users/staig/documents/uni/master/signalgenerator/fpga_signalgenerator/code_loesung/toplevel.vhd(39[9:11])
    OB A4_pad (.I(led4_c), .O(A4));   // c:/users/staig/documents/uni/master/signalgenerator/fpga_signalgenerator/code_loesung/toplevel.vhd(40[9:11])
    OB A5_pad (.I(led5_c), .O(A5));   // c:/users/staig/documents/uni/master/signalgenerator/fpga_signalgenerator/code_loesung/toplevel.vhd(41[9:11])
    OB A6_pad (.I(led6_c), .O(A6));   // c:/users/staig/documents/uni/master/signalgenerator/fpga_signalgenerator/code_loesung/toplevel.vhd(42[9:11])
    OB A7_pad (.I(led7_c), .O(A7));   // c:/users/staig/documents/uni/master/signalgenerator/fpga_signalgenerator/code_loesung/toplevel.vhd(43[9:11])
    OB A8_pad (.I(led8_c), .O(A8));   // c:/users/staig/documents/uni/master/signalgenerator/fpga_signalgenerator/code_loesung/toplevel.vhd(44[9:11])
    OB led1_pad (.I(led1_c), .O(led1));   // c:/users/staig/documents/uni/master/signalgenerator/fpga_signalgenerator/code_loesung/toplevel.vhd(48[9:13])
    OB led2_pad (.I(led2_c), .O(led2));   // c:/users/staig/documents/uni/master/signalgenerator/fpga_signalgenerator/code_loesung/toplevel.vhd(49[9:13])
    OB led3_pad (.I(led3_c), .O(led3));   // c:/users/staig/documents/uni/master/signalgenerator/fpga_signalgenerator/code_loesung/toplevel.vhd(50[9:13])
    OB led4_pad (.I(led4_c), .O(led4));   // c:/users/staig/documents/uni/master/signalgenerator/fpga_signalgenerator/code_loesung/toplevel.vhd(51[9:13])
    OB led5_pad (.I(led5_c), .O(led5));   // c:/users/staig/documents/uni/master/signalgenerator/fpga_signalgenerator/code_loesung/toplevel.vhd(52[9:13])
    OB led6_pad (.I(led6_c), .O(led6));   // c:/users/staig/documents/uni/master/signalgenerator/fpga_signalgenerator/code_loesung/toplevel.vhd(53[9:13])
    OB led7_pad (.I(led7_c), .O(led7));   // c:/users/staig/documents/uni/master/signalgenerator/fpga_signalgenerator/code_loesung/toplevel.vhd(54[9:13])
    OB led8_pad (.I(led8_c), .O(led8));   // c:/users/staig/documents/uni/master/signalgenerator/fpga_signalgenerator/code_loesung/toplevel.vhd(55[9:13])
    IB clk_pad (.I(clk), .O(clk_c));   // c:/users/staig/documents/uni/master/signalgenerator/fpga_signalgenerator/code_loesung/toplevel.vhd(20[9:12])
    IB btn_mode_pad (.I(btn_mode), .O(btn_mode_c));   // c:/users/staig/documents/uni/master/signalgenerator/fpga_signalgenerator/code_loesung/toplevel.vhd(23[9:17])
    IB btn_param_pad (.I(btn_param), .O(btn_param_c));   // c:/users/staig/documents/uni/master/signalgenerator/fpga_signalgenerator/code_loesung/toplevel.vhd(24[9:18])
    IB btn_inc_pad (.I(btn_inc), .O(btn_inc_c));   // c:/users/staig/documents/uni/master/signalgenerator/fpga_signalgenerator/code_loesung/toplevel.vhd(25[9:16])
    IB btn_plus_pad (.I(btn_plus), .O(btn_plus_c));   // c:/users/staig/documents/uni/master/signalgenerator/fpga_signalgenerator/code_loesung/toplevel.vhd(26[9:17])
    IB btn_minus_pad (.I(btn_minus), .O(btn_minus_c));   // c:/users/staig/documents/uni/master/signalgenerator/fpga_signalgenerator/code_loesung/toplevel.vhd(27[9:18])
    PFUMX sig_mode_2__I_0_Mux_6_i7 (.BLUT(n4_adj_685), .ALUT(n6_adj_684), 
          .C0(n5882), .Z(led2_c));
    PFUMX led_W_normal_15__I_0_i3 (.BLUT(led_W_out_15__N_70[2]), .ALUT(led_W_normal[2]), 
          .C0(n5791), .Z(led_W_c_2));
    ORCALUT4 i15_4_lut (.A(note_index[0]), .B(flag_inc_status_3__N_98), 
            .C(n6128), .D(flag_inc_status_3__N_234[2]), .Z(led_inc_c_2)) /* synthesis lut_function=(!(A (B+(C+!(D)))+!A !(B (C)+!B (C+(D))))) */ ;   // c:/users/staig/documents/uni/master/signalgenerator/fpga_signalgenerator/code_loesung/toplevel.vhd(159[18:75])
    defparam i15_4_lut.init = 16'h5350;
    PFUMX led_W_normal_15__I_0_i4 (.BLUT(led_W_out_15__N_70[3]), .ALUT(led_W_normal[3]), 
          .C0(n5791), .Z(led_W_c_3));
    ORCALUT4 led_W_normal_15__I_0_i10_3_lut_4_lut (.A(sig_mode[1]), .B(n6133), 
            .C(led_W_normal[9]), .D(n6137), .Z(led_W_c_9)) /* synthesis lut_function=(A (B (C)+!B (D))+!A (C)) */ ;   // c:/users/staig/documents/uni/master/signalgenerator/fpga_signalgenerator/code_loesung/toplevel.vhd(158[39:55])
    defparam led_W_normal_15__I_0_i10_3_lut_4_lut.init = 16'hf2d0;
    PFUMX led_W_normal_15__I_0_i5 (.BLUT(led_W_out_15__N_70[4]), .ALUT(led_W_normal[4]), 
          .C0(n5791), .Z(led_W_c_4));
    ORCALUT4 led_W_normal_15__I_0_i13_3_lut_4_lut (.A(sig_mode[1]), .B(n6133), 
            .C(led_W_normal[12]), .D(note_index[0]), .Z(led_W_c_12)) /* synthesis lut_function=(A (B (C)+!B !(D))+!A (C)) */ ;   // c:/users/staig/documents/uni/master/signalgenerator/fpga_signalgenerator/code_loesung/toplevel.vhd(158[39:55])
    defparam led_W_normal_15__I_0_i13_3_lut_4_lut.init = 16'hd0f2;
    ORCALUT4 led_inc_normal_3__I_0_i2_4_lut (.A(n6137), .B(flag_inc_status_3__N_238), 
            .C(n6128), .D(flag_inc_status_3__N_98), .Z(led_inc_c_1)) /* synthesis lut_function=(A (B (C+!(D))+!B (C))+!A !((C+(D))+!B)) */ ;   // c:/users/staig/documents/uni/master/signalgenerator/fpga_signalgenerator/code_loesung/toplevel.vhd(159[18:75])
    defparam led_inc_normal_3__I_0_i2_4_lut.init = 16'ha0ac;
    PFUMX led_W_normal_15__I_0_i6 (.BLUT(led_W_out_15__N_70[5]), .ALUT(led_W_normal[5]), 
          .C0(n5791), .Z(led_W_c_5));
    ORCALUT4 i2010_4_lut (.A(wave_sin[4]), .B(sig_mode[0]), .C(wave_tri[4]), 
            .D(sig_mode[1]), .Z(n2678)) /* synthesis lut_function=(A (B (C+!(D)))+!A (B (C (D)))) */ ;   // c:/users/staig/documents/uni/master/signalgenerator/fpga_signalgenerator/code_loesung/toplevel.vhd(221[5] 228[50])
    defparam i2010_4_lut.init = 16'hc088;
    PFUMX led_W_normal_15__I_0_i7 (.BLUT(led_W_out_15__N_70[6]), .ALUT(led_W_normal[6]), 
          .C0(n5791), .Z(led_W_c_6));
    PFUMX led_W_normal_15__I_0_i8 (.BLUT(led_W_out_15__N_70[7]), .ALUT(led_W_normal[7]), 
          .C0(n5791), .Z(led_W_c_7));
    PFUMX sig_mode_2__I_0_Mux_5_i7 (.BLUT(n4_adj_683), .ALUT(n6_adj_682), 
          .C0(n5882), .Z(led3_c));
    PFUMX sig_mode_2__I_0_Mux_4_i7 (.BLUT(n4), .ALUT(n6), .C0(n5882), 
          .Z(led4_c));
    ORCALUT4 led_W_out_15__I_0_i4_3_lut_4_lut (.A(sig_mode[1]), .B(n6133), 
            .C(n6137), .D(sig_p1[3]), .Z(led_W_normal[3])) /* synthesis lut_function=(A (B (D)+!B (C))+!A (D)) */ ;   // c:/users/staig/documents/uni/master/signalgenerator/fpga_signalgenerator/code_loesung/toplevel.vhd(158[39:55])
    defparam led_W_out_15__I_0_i4_3_lut_4_lut.init = 16'hfd20;
    PFUMX sig_mode_2__I_0_Mux_3_i7 (.BLUT(n4_adj_674), .ALUT(n6_adj_675), 
          .C0(n5882), .Z(led5_c));
    PFUMX sig_mode_2__I_0_Mux_2_i7 (.BLUT(n4_adj_676), .ALUT(n6_adj_677), 
          .C0(n5882), .Z(led6_c));
    PFUMX sig_mode_2__I_0_Mux_1_i7 (.BLUT(n4_adj_678), .ALUT(n6_adj_679), 
          .C0(n5882), .Z(led7_c));
    PFUMX sig_mode_2__I_0_Mux_0_i7 (.BLUT(n4_adj_680), .ALUT(n6_adj_681), 
          .C0(n5882), .Z(led8_c));
    PFUMX led_W_normal_15__I_0_i1 (.BLUT(led_W_out_15__N_70[0]), .ALUT(led_W_normal[0]), 
          .C0(n5791), .Z(led_W_c_0));
    ORCALUT4 i4073_3_lut (.A(sw5_clean), .B(sync1_adj_670), .C(btn_clean_N_289_adj_671), 
            .Z(n5785)) /* synthesis lut_function=(A (B+!(C))+!A (B (C))) */ ;
    defparam i4073_3_lut.init = 16'hcaca;
    ORCALUT4 i4074_3_lut (.A(sw4_clean), .B(sync1_adj_668), .C(btn_clean_N_289_adj_669), 
            .Z(n5786)) /* synthesis lut_function=(A (B+!(C))+!A (B (C))) */ ;
    defparam i4074_3_lut.init = 16'hcaca;
    ORCALUT4 led_W_out_15__I_0_i6_3_lut_4_lut (.A(sig_mode[1]), .B(n6133), 
            .C(n6137), .D(sig_p1[5]), .Z(led_W_normal[5])) /* synthesis lut_function=(A (B (D)+!B (C))+!A (D)) */ ;   // c:/users/staig/documents/uni/master/signalgenerator/fpga_signalgenerator/code_loesung/toplevel.vhd(158[39:55])
    defparam led_W_out_15__I_0_i6_3_lut_4_lut.init = 16'hfd20;
    dreieck_gen gen_tri (.sig_p1({sig_p1}), .GND_net(GND_net), .VCC_net(VCC_net), 
            .wave_tri({wave_tri}), .\sig_amp[6] (sig_amp[6]), .is_rising(is_rising), 
            .\sig_amp[2] (sig_amp[2]), .\sig_amp[1] (sig_amp[1]), .clk_c(clk_c), 
            .n5789(n5789), .clk_c_enable_104(clk_c_enable_104), .\sig_amp[7] (sig_amp[7]), 
            .\sig_amp[4] (sig_amp[4]), .\sig_amp[3] (sig_amp[3]), .n3648(n3648), 
            .\sig_amp[5] (sig_amp[5]), .n14(n14), .n6310(n6310));   // c:/users/staig/documents/uni/master/signalgenerator/fpga_signalgenerator/code_loesung/toplevel.vhd(181[15:38])
    mystery gen_mystery (.clk_c(clk_c), .\note_index[0] (note_index[0]), 
            .wave_mystery({wave_mystery}), .GND_net(GND_net), .VCC_net(VCC_net), 
            .n6137(n6137));   // c:/users/staig/documents/uni/master/signalgenerator/fpga_signalgenerator/code_loesung/toplevel.vhd(213[19:38])
    ORCALUT4 i4075_3_lut (.A(sw2_clean), .B(sync1), .C(btn_clean_N_289), 
            .Z(n5787)) /* synthesis lut_function=(A (B+!(C))+!A (B (C))) */ ;
    defparam i4075_3_lut.init = 16'hcaca;
    rect_gen gen_rect (.\wave_rect[7] (wave_rect[7]), .clk_c(clk_c), .clk_c_enable_104(clk_c_enable_104), 
            .n6310(n6310), .GND_net(GND_net), .VCC_net(VCC_net), .sig_p1({sig_p1}), 
            .tick_en(tick_en));   // c:/users/staig/documents/uni/master/signalgenerator/fpga_signalgenerator/code_loesung/toplevel.vhd(171[16:36])
    sinus_gen gen_sin (.clk_c(clk_c), .wave_sin({wave_sin}), .clk_c_enable_104(clk_c_enable_104), 
            .sig_amp({sig_amp}), .GND_net(GND_net), .VCC_net(VCC_net), 
            .\sig_p1[8] (sig_p1[8]), .\sig_p1[9] (sig_p1[9]), .\sig_p1[6] (sig_p1[6]), 
            .\sig_p1[7] (sig_p1[7]), .\sig_p1[4] (sig_p1[4]), .\sig_p1[5] (sig_p1[5]), 
            .\sig_p1[2] (sig_p1[2]), .\sig_p1[3] (sig_p1[3]), .\sig_p1[0] (sig_p1[0]), 
            .\sig_p1[1] (sig_p1[1]));   // c:/users/staig/documents/uni/master/signalgenerator/fpga_signalgenerator/code_loesung/toplevel.vhd(192[15:36])
    ORCALUT4 i4072_3_lut (.A(sw6_clean), .B(sync1_adj_672), .C(btn_clean_N_289_adj_673), 
            .Z(n5784)) /* synthesis lut_function=(A (B+!(C))+!A (B (C))) */ ;
    defparam i4072_3_lut.init = 16'hcaca;
    ORCALUT4 i1991_4_lut (.A(wave_sin[5]), .B(sig_mode[0]), .C(wave_tri[5]), 
            .D(sig_mode[1]), .Z(n2680)) /* synthesis lut_function=(A (B (C+!(D)))+!A (B (C (D)))) */ ;   // c:/users/staig/documents/uni/master/signalgenerator/fpga_signalgenerator/code_loesung/toplevel.vhd(221[5] 228[50])
    defparam i1991_4_lut.init = 16'hc088;
    PUR PUR_INST (.PUR(VCC_net));
    defparam PUR_INST.RST_PULSE = 1;
    VLO i1 (.Z(GND_net));
    steuerung control_inst (.sig_p2({sig_p2}), .sw6_clean(sw6_clean), .\inc_val_reg[0] (inc_val_reg[0]), 
            .\inc_val_reg[1] (inc_val_reg[1]), .GND_net(GND_net), .VCC_net(VCC_net), 
            .clk_c(clk_c), .sw3_clean(sw3_clean), .sig_mode({sig_mode}), 
            .n6128(n6128), .sw4_clean(sw4_clean), .sw5_clean(sw5_clean), 
            .sig_amp({sig_amp}), .sw2_clean(sw2_clean), .n6147(n6147), 
            .sig_p1({sig_p1}), .flag_inc_status_3__N_98(flag_inc_status_3__N_98), 
            .\inc_val_reg[2] (inc_val_reg[2]), .flag_inc_status_3__N_238(flag_inc_status_3__N_238), 
            .\inc_val_reg[3] (inc_val_reg[3]), .\inc_val_reg_15__N_131[3] (inc_val_reg_15__N_131[3]), 
            .\inc_val_reg[5] (inc_val_reg[5]), .\inc_val_reg[9] (inc_val_reg[9]), 
            .\flag_inc_status_3__N_234[2] (flag_inc_status_3__N_234[2]), .n6149(n6149), 
            .n5349(n5349), .param_sel_reg({param_sel_reg[1], Open_0}), 
            .\led_W_normal[10] (led_W_normal[10]), .n5791(n5791), .\led_W_normal[9] (led_W_normal[9]), 
            .\led_W_normal[8] (led_W_normal[8]), .\led_W_normal[15] (led_W_normal[15]), 
            .\led_W_normal[14] (led_W_normal[14]), .\led_W_normal[13] (led_W_normal[13]), 
            .\led_W_normal[12] (led_W_normal[12]), .\led_W_normal[11] (led_W_normal[11]), 
            .n6133(n6133), .n5335(n5335), .\led_W_out_15__N_70[0] (led_W_out_15__N_70[0]), 
            .\led_W_out_15__N_70[4] (led_W_out_15__N_70[4]), .\led_W_out_15__N_70[5] (led_W_out_15__N_70[5]), 
            .\led_W_out_15__N_70[6] (led_W_out_15__N_70[6]), .\led_W_out_15__N_70[7] (led_W_out_15__N_70[7]), 
            .\led_W_out_15__N_70[3] (led_W_out_15__N_70[3]), .\led_W_out_15__N_70[2] (led_W_out_15__N_70[2]), 
            .\led_W_out_15__N_70[1] (led_W_out_15__N_70[1]), .\note_index[0] (note_index[0]), 
            .led_Modus_c_4(led_Modus_c_4), .led_Modus_c_2(led_Modus_c_2), 
            .wave_mystery({wave_mystery}), .n2674(n2674), .n6(n6_adj_677), 
            .led_Modus_c_5(led_Modus_c_5), .n2676(n2676), .n6_adj_1(n6_adj_675), 
            .n2670(n2670), .n6_adj_2(n6_adj_681), .n2678(n2678), .n6_adj_3(n6), 
            .n2680(n2680), .n6_adj_4(n6_adj_682), .n6137(n6137), .led_Modus_c_3(led_Modus_c_3), 
            .n2684(n2684), .n6_adj_5(n6_adj_686), .led_Modus_c_1(led_Modus_c_1), 
            .n2672(n2672), .n6_adj_6(n6_adj_679), .n2682(n2682), .n6_adj_7(n6_adj_684), 
            .led_Modus_c_0(led_Modus_c_0), .sync1(sync1_adj_670), .btn_plus_c(btn_plus_c), 
            .n5785(n5785), .btn_clean_N_289(btn_clean_N_289_adj_671), .sync1_adj_8(sync1_adj_666), 
            .btn_clean_N_289_adj_9(btn_clean_N_289_adj_667), .btn_param_c(btn_param_c), 
            .n5788(n5788), .sync1_adj_10(sync1), .btn_mode_c(btn_mode_c), 
            .btn_clean_N_289_adj_11(btn_clean_N_289), .n5787(n5787), .sync1_adj_12(sync1_adj_672), 
            .btn_minus_c(btn_minus_c), .n5784(n5784), .btn_clean_N_289_adj_13(btn_clean_N_289_adj_673), 
            .sync1_adj_14(sync1_adj_668), .btn_inc_c(btn_inc_c), .n5786(n5786), 
            .btn_clean_N_289_adj_15(btn_clean_N_289_adj_669));   // c:/users/staig/documents/uni/master/signalgenerator/fpga_signalgenerator/code_loesung/toplevel.vhd(113[20:41])
    
endmodule
//
// Verilog Description of module saegezahn_gen
//

module saegezahn_gen (wave_saw, \sig_amp[7] , \sig_amp[6] , \sig_amp[5] , 
            \sig_amp[4] , \sig_amp[3] , clk_c, \sig_amp[2] , sig_p1, 
            GND_net, VCC_net, clk_c_enable_104, \sig_amp[1] , n6310);
    output [7:0]wave_saw;
    input \sig_amp[7] ;
    input \sig_amp[6] ;
    input \sig_amp[5] ;
    input \sig_amp[4] ;
    input \sig_amp[3] ;
    input clk_c;
    input \sig_amp[2] ;
    input [15:0]sig_p1;
    input GND_net;
    input VCC_net;
    input clk_c_enable_104;
    input \sig_amp[1] ;
    input n6310;
    
    wire clk_c /* synthesis SET_AS_NETWORK=clk_c, is_clock=1 */ ;   // c:/users/staig/documents/uni/master/signalgenerator/fpga_signalgenerator/code_loesung/toplevel.vhd(20[9:12])
    
    wire n6154, n11, n6155, n5842, n5851, n14, n6, n1643;
    wire [7:0]out_8bit_7__N_506;
    
    wire n5608, n675, n7, n5606, n5604, n5602, n6127, n5598, 
        clk_c_enable_58, n5600, n4586;
    wire [15:0]tick_counter;   // c:/users/staig/documents/uni/master/signalgenerator/fpga_signalgenerator/code_loesung/saegezahn_gen.vhd(31[12:24])
    
    wire n4587;
    wire [15:0]n69;
    
    wire n4582, n4583, n4, n4588, n6132, n10, n12, n4701, n4700, 
        n4699, n4698, n8, n4697, n4696, n4695, n4694, n6156, 
        n4581, n4584, n4585, n6_adj_665, n6135, n5610;
    
    ORCALUT4 i4221_4_lut (.A(n6154), .B(n11), .C(n6155), .D(n5842), 
            .Z(n5851)) /* synthesis lut_function=(A+!(B (C+!(D)))) */ ;   // c:/users/staig/documents/uni/master/signalgenerator/fpga_signalgenerator/code_loesung/saegezahn_gen.vhd(45[28:50])
    defparam i4221_4_lut.init = 16'hbfbb;
    ORCALUT4 i1_4_lut_4_lut (.A(wave_saw[7]), .B(n14), .C(n6), .D(n1643), 
            .Z(out_8bit_7__N_506[7])) /* synthesis lut_function=(!(A (B+((D)+!C))+!A !(C (D)))) */ ;
    defparam i1_4_lut_4_lut.init = 16'h5020;
    ORCALUT4 mux_15_i7_4_lut (.A(n5608), .B(\sig_amp[7] ), .C(n675), .D(n7), 
            .Z(out_8bit_7__N_506[6])) /* synthesis lut_function=(!(A (B (C+(D))+!B !(C+!(D)))+!A (B+!(C)))) */ ;   // c:/users/staig/documents/uni/master/signalgenerator/fpga_signalgenerator/code_loesung/saegezahn_gen.vhd(40[17] 60[24])
    defparam mux_15_i7_4_lut.init = 16'h303a;
    ORCALUT4 mux_15_i6_4_lut (.A(n5606), .B(\sig_amp[6] ), .C(n675), .D(n7), 
            .Z(out_8bit_7__N_506[5])) /* synthesis lut_function=(!(A (B (C+(D))+!B !(C+!(D)))+!A (B+!(C)))) */ ;   // c:/users/staig/documents/uni/master/signalgenerator/fpga_signalgenerator/code_loesung/saegezahn_gen.vhd(40[17] 60[24])
    defparam mux_15_i6_4_lut.init = 16'h303a;
    ORCALUT4 mux_15_i5_4_lut (.A(n5604), .B(\sig_amp[5] ), .C(n675), .D(n7), 
            .Z(out_8bit_7__N_506[4])) /* synthesis lut_function=(!(A (B (C+(D))+!B !(C+!(D)))+!A (B+!(C)))) */ ;   // c:/users/staig/documents/uni/master/signalgenerator/fpga_signalgenerator/code_loesung/saegezahn_gen.vhd(40[17] 60[24])
    defparam mux_15_i5_4_lut.init = 16'h303a;
    ORCALUT4 mux_15_i4_4_lut (.A(n5602), .B(\sig_amp[4] ), .C(n675), .D(n7), 
            .Z(out_8bit_7__N_506[3])) /* synthesis lut_function=(!(A (B (C+(D))+!B !(C+!(D)))+!A (B+!(C)))) */ ;   // c:/users/staig/documents/uni/master/signalgenerator/fpga_signalgenerator/code_loesung/saegezahn_gen.vhd(40[17] 60[24])
    defparam mux_15_i4_4_lut.init = 16'h303a;
    ORCALUT4 i1_3_lut_4_lut (.A(wave_saw[5]), .B(n6127), .C(n6), .D(wave_saw[6]), 
            .Z(n5608)) /* synthesis lut_function=(!(A (B ((D)+!C)+!B !(C (D)))+!A !(C (D)))) */ ;   // C:/lscc/diamond/3.14/ispfpga/vhdl_packages/numeric_std.vhd(1241[12:13])
    defparam i1_3_lut_4_lut.init = 16'h7080;
    ORCALUT4 mux_15_i3_4_lut (.A(n5598), .B(\sig_amp[3] ), .C(n675), .D(n7), 
            .Z(out_8bit_7__N_506[2])) /* synthesis lut_function=(!(A (B (C+(D))+!B !(C+!(D)))+!A (B+!(C)))) */ ;   // c:/users/staig/documents/uni/master/signalgenerator/fpga_signalgenerator/code_loesung/saegezahn_gen.vhd(40[17] 60[24])
    defparam mux_15_i3_4_lut.init = 16'h303a;
    FD1P3AX current_val_i0_i0 (.D(out_8bit_7__N_506[0]), .SP(clk_c_enable_58), 
            .CK(clk_c), .Q(wave_saw[0])) /* synthesis lse_init_val=0, LSE_LINE_FILE_ID=20, LSE_LCOL=15, LSE_RCOL=40, LSE_LLINE=201, LSE_RLINE=201 */ ;   // c:/users/staig/documents/uni/master/signalgenerator/fpga_signalgenerator/code_loesung/saegezahn_gen.vhd(37[9] 63[16])
    defparam current_val_i0_i0.GSR = "ENABLED";
    ORCALUT4 mux_15_i2_4_lut (.A(n5600), .B(\sig_amp[2] ), .C(n675), .D(n7), 
            .Z(out_8bit_7__N_506[1])) /* synthesis lut_function=(!(A (B (C+(D))+!B !(C+!(D)))+!A (B+!(C)))) */ ;   // c:/users/staig/documents/uni/master/signalgenerator/fpga_signalgenerator/code_loesung/saegezahn_gen.vhd(40[17] 60[24])
    defparam mux_15_i2_4_lut.init = 16'h303a;
    ORCALUT4 i1_3_lut (.A(n6), .B(wave_saw[1]), .C(wave_saw[0]), .Z(n5600)) /* synthesis lut_function=(!((B (C)+!B !(C))+!A)) */ ;
    defparam i1_3_lut.init = 16'h2828;
    CCU2B add_812_add_4_14 (.A0(tick_counter[11]), .B0(sig_p1[11]), .C0(GND_net), 
          .D0(VCC_net), .A1(tick_counter[12]), .B1(sig_p1[12]), .C1(GND_net), 
          .D1(VCC_net), .CIN(n4586), .COUT(n4587));
    defparam add_812_add_4_14.INIT0 = 16'h999a;
    defparam add_812_add_4_14.INIT1 = 16'h999a;
    defparam add_812_add_4_14.INJECT1_0 = "NO";
    defparam add_812_add_4_14.INJECT1_1 = "NO";
    FD1P3IX tick_counter_433__i1 (.D(n69[1]), .SP(clk_c_enable_104), .CD(clk_c_enable_58), 
            .CK(clk_c), .Q(tick_counter[1])) /* synthesis syn_use_carry_chain=1 */ ;   // C:/lscc/diamond/3.14/ispfpga/vhdl_packages/numeric_std.vhd(1241[12:13])
    defparam tick_counter_433__i1.GSR = "ENABLED";
    ORCALUT4 LessThan_8_i11_2_lut (.A(\sig_amp[6] ), .B(wave_saw[5]), .Z(n11)) /* synthesis lut_function=(A (B)+!A !(B)) */ ;   // c:/users/staig/documents/uni/master/signalgenerator/fpga_signalgenerator/code_loesung/saegezahn_gen.vhd(45[28:50])
    defparam LessThan_8_i11_2_lut.init = 16'h9999;
    CCU2B add_812_add_4_6 (.A0(tick_counter[3]), .B0(sig_p1[3]), .C0(GND_net), 
          .D0(VCC_net), .A1(tick_counter[4]), .B1(sig_p1[4]), .C1(GND_net), 
          .D1(VCC_net), .CIN(n4582), .COUT(n4583));
    defparam add_812_add_4_6.INIT0 = 16'h999a;
    defparam add_812_add_4_6.INIT1 = 16'h999a;
    defparam add_812_add_4_6.INJECT1_0 = "NO";
    defparam add_812_add_4_6.INJECT1_1 = "NO";
    ORCALUT4 LessThan_8_i4_4_lut (.A(wave_saw[0]), .B(wave_saw[1]), .C(\sig_amp[2] ), 
            .D(\sig_amp[1] ), .Z(n4)) /* synthesis lut_function=(A (B+!(C))+!A !(B (C (D))+!B (C+(D)))) */ ;   // c:/users/staig/documents/uni/master/signalgenerator/fpga_signalgenerator/code_loesung/saegezahn_gen.vhd(45[28:50])
    defparam LessThan_8_i4_4_lut.init = 16'h8ecf;
    FD1P3IX tick_counter_433__i2 (.D(n69[2]), .SP(clk_c_enable_104), .CD(clk_c_enable_58), 
            .CK(clk_c), .Q(tick_counter[2])) /* synthesis syn_use_carry_chain=1 */ ;   // C:/lscc/diamond/3.14/ispfpga/vhdl_packages/numeric_std.vhd(1241[12:13])
    defparam tick_counter_433__i2.GSR = "ENABLED";
    CCU2B add_812_add_4_18 (.A0(tick_counter[15]), .B0(sig_p1[15]), .C0(GND_net), 
          .D0(VCC_net), .A1(GND_net), .B1(GND_net), .C1(GND_net), .D1(GND_net), 
          .CIN(n4588), .S1(n6));
    defparam add_812_add_4_18.INIT0 = 16'h999a;
    defparam add_812_add_4_18.INIT1 = 16'h0000;
    defparam add_812_add_4_18.INJECT1_0 = "NO";
    defparam add_812_add_4_18.INJECT1_1 = "NO";
    FD1P3AX current_val_i0_i7 (.D(out_8bit_7__N_506[7]), .SP(clk_c_enable_58), 
            .CK(clk_c), .Q(wave_saw[7])) /* synthesis lse_init_val=0, LSE_LINE_FILE_ID=20, LSE_LCOL=15, LSE_RCOL=40, LSE_LLINE=201, LSE_RLINE=201 */ ;   // c:/users/staig/documents/uni/master/signalgenerator/fpga_signalgenerator/code_loesung/saegezahn_gen.vhd(37[9] 63[16])
    defparam current_val_i0_i7.GSR = "ENABLED";
    ORCALUT4 i710_2_lut_3_lut_4_lut (.A(wave_saw[4]), .B(n6132), .C(wave_saw[6]), 
            .D(wave_saw[5]), .Z(n1643)) /* synthesis lut_function=(A (B (C (D)))) */ ;   // C:/lscc/diamond/3.14/ispfpga/vhdl_packages/numeric_std.vhd(1241[12:13])
    defparam i710_2_lut_3_lut_4_lut.init = 16'h8000;
    FD1P3IX tick_counter_433__i3 (.D(n69[3]), .SP(clk_c_enable_104), .CD(clk_c_enable_58), 
            .CK(clk_c), .Q(tick_counter[3])) /* synthesis syn_use_carry_chain=1 */ ;   // C:/lscc/diamond/3.14/ispfpga/vhdl_packages/numeric_std.vhd(1241[12:13])
    defparam tick_counter_433__i3.GSR = "ENABLED";
    FD1P3AX current_val_i0_i6 (.D(out_8bit_7__N_506[6]), .SP(clk_c_enable_58), 
            .CK(clk_c), .Q(wave_saw[6])) /* synthesis lse_init_val=0, LSE_LINE_FILE_ID=20, LSE_LCOL=15, LSE_RCOL=40, LSE_LLINE=201, LSE_RLINE=201 */ ;   // c:/users/staig/documents/uni/master/signalgenerator/fpga_signalgenerator/code_loesung/saegezahn_gen.vhd(37[9] 63[16])
    defparam current_val_i0_i6.GSR = "ENABLED";
    FD1P3AX current_val_i0_i5 (.D(out_8bit_7__N_506[5]), .SP(clk_c_enable_58), 
            .CK(clk_c), .Q(wave_saw[5])) /* synthesis lse_init_val=0, LSE_LINE_FILE_ID=20, LSE_LCOL=15, LSE_RCOL=40, LSE_LLINE=201, LSE_RLINE=201 */ ;   // c:/users/staig/documents/uni/master/signalgenerator/fpga_signalgenerator/code_loesung/saegezahn_gen.vhd(37[9] 63[16])
    defparam current_val_i0_i5.GSR = "ENABLED";
    FD1P3AX current_val_i0_i4 (.D(out_8bit_7__N_506[4]), .SP(clk_c_enable_58), 
            .CK(clk_c), .Q(wave_saw[4])) /* synthesis lse_init_val=0, LSE_LINE_FILE_ID=20, LSE_LCOL=15, LSE_RCOL=40, LSE_LLINE=201, LSE_RLINE=201 */ ;   // c:/users/staig/documents/uni/master/signalgenerator/fpga_signalgenerator/code_loesung/saegezahn_gen.vhd(37[9] 63[16])
    defparam current_val_i0_i4.GSR = "ENABLED";
    FD1P3AX current_val_i0_i3 (.D(out_8bit_7__N_506[3]), .SP(clk_c_enable_58), 
            .CK(clk_c), .Q(wave_saw[3])) /* synthesis lse_init_val=0, LSE_LINE_FILE_ID=20, LSE_LCOL=15, LSE_RCOL=40, LSE_LLINE=201, LSE_RLINE=201 */ ;   // c:/users/staig/documents/uni/master/signalgenerator/fpga_signalgenerator/code_loesung/saegezahn_gen.vhd(37[9] 63[16])
    defparam current_val_i0_i3.GSR = "ENABLED";
    FD1P3AX current_val_i0_i2 (.D(out_8bit_7__N_506[2]), .SP(clk_c_enable_58), 
            .CK(clk_c), .Q(wave_saw[2])) /* synthesis lse_init_val=0, LSE_LINE_FILE_ID=20, LSE_LCOL=15, LSE_RCOL=40, LSE_LLINE=201, LSE_RLINE=201 */ ;   // c:/users/staig/documents/uni/master/signalgenerator/fpga_signalgenerator/code_loesung/saegezahn_gen.vhd(37[9] 63[16])
    defparam current_val_i0_i2.GSR = "ENABLED";
    FD1P3AX current_val_i0_i1 (.D(out_8bit_7__N_506[1]), .SP(clk_c_enable_58), 
            .CK(clk_c), .Q(wave_saw[1])) /* synthesis lse_init_val=0, LSE_LINE_FILE_ID=20, LSE_LCOL=15, LSE_RCOL=40, LSE_LLINE=201, LSE_RLINE=201 */ ;   // c:/users/staig/documents/uni/master/signalgenerator/fpga_signalgenerator/code_loesung/saegezahn_gen.vhd(37[9] 63[16])
    defparam current_val_i0_i1.GSR = "ENABLED";
    ORCALUT4 i1_3_lut_4_lut_adj_53 (.A(wave_saw[4]), .B(n6132), .C(n6), 
            .D(wave_saw[5]), .Z(n5606)) /* synthesis lut_function=(!(A (B ((D)+!C)+!B !(C (D)))+!A !(C (D)))) */ ;   // C:/lscc/diamond/3.14/ispfpga/vhdl_packages/numeric_std.vhd(1241[12:13])
    defparam i1_3_lut_4_lut_adj_53.init = 16'h7080;
    FD1P3IX tick_counter_433__i4 (.D(n69[4]), .SP(clk_c_enable_104), .CD(clk_c_enable_58), 
            .CK(clk_c), .Q(tick_counter[4])) /* synthesis syn_use_carry_chain=1 */ ;   // C:/lscc/diamond/3.14/ispfpga/vhdl_packages/numeric_std.vhd(1241[12:13])
    defparam tick_counter_433__i4.GSR = "ENABLED";
    FD1P3IX tick_counter_433__i5 (.D(n69[5]), .SP(clk_c_enable_104), .CD(clk_c_enable_58), 
            .CK(clk_c), .Q(tick_counter[5])) /* synthesis syn_use_carry_chain=1 */ ;   // C:/lscc/diamond/3.14/ispfpga/vhdl_packages/numeric_std.vhd(1241[12:13])
    defparam tick_counter_433__i5.GSR = "ENABLED";
    FD1P3IX tick_counter_433__i6 (.D(n69[6]), .SP(clk_c_enable_104), .CD(clk_c_enable_58), 
            .CK(clk_c), .Q(tick_counter[6])) /* synthesis syn_use_carry_chain=1 */ ;   // C:/lscc/diamond/3.14/ispfpga/vhdl_packages/numeric_std.vhd(1241[12:13])
    defparam tick_counter_433__i6.GSR = "ENABLED";
    FD1P3IX tick_counter_433__i7 (.D(n69[7]), .SP(clk_c_enable_104), .CD(clk_c_enable_58), 
            .CK(clk_c), .Q(tick_counter[7])) /* synthesis syn_use_carry_chain=1 */ ;   // C:/lscc/diamond/3.14/ispfpga/vhdl_packages/numeric_std.vhd(1241[12:13])
    defparam tick_counter_433__i7.GSR = "ENABLED";
    FD1P3IX tick_counter_433__i8 (.D(n69[8]), .SP(clk_c_enable_104), .CD(clk_c_enable_58), 
            .CK(clk_c), .Q(tick_counter[8])) /* synthesis syn_use_carry_chain=1 */ ;   // C:/lscc/diamond/3.14/ispfpga/vhdl_packages/numeric_std.vhd(1241[12:13])
    defparam tick_counter_433__i8.GSR = "ENABLED";
    FD1P3IX tick_counter_433__i9 (.D(n69[9]), .SP(clk_c_enable_104), .CD(clk_c_enable_58), 
            .CK(clk_c), .Q(tick_counter[9])) /* synthesis syn_use_carry_chain=1 */ ;   // C:/lscc/diamond/3.14/ispfpga/vhdl_packages/numeric_std.vhd(1241[12:13])
    defparam tick_counter_433__i9.GSR = "ENABLED";
    FD1P3IX tick_counter_433__i10 (.D(n69[10]), .SP(clk_c_enable_104), .CD(clk_c_enable_58), 
            .CK(clk_c), .Q(tick_counter[10])) /* synthesis syn_use_carry_chain=1 */ ;   // C:/lscc/diamond/3.14/ispfpga/vhdl_packages/numeric_std.vhd(1241[12:13])
    defparam tick_counter_433__i10.GSR = "ENABLED";
    FD1P3IX tick_counter_433__i11 (.D(n69[11]), .SP(clk_c_enable_104), .CD(clk_c_enable_58), 
            .CK(clk_c), .Q(tick_counter[11])) /* synthesis syn_use_carry_chain=1 */ ;   // C:/lscc/diamond/3.14/ispfpga/vhdl_packages/numeric_std.vhd(1241[12:13])
    defparam tick_counter_433__i11.GSR = "ENABLED";
    FD1P3IX tick_counter_433__i12 (.D(n69[12]), .SP(clk_c_enable_104), .CD(clk_c_enable_58), 
            .CK(clk_c), .Q(tick_counter[12])) /* synthesis syn_use_carry_chain=1 */ ;   // C:/lscc/diamond/3.14/ispfpga/vhdl_packages/numeric_std.vhd(1241[12:13])
    defparam tick_counter_433__i12.GSR = "ENABLED";
    FD1P3IX tick_counter_433__i13 (.D(n69[13]), .SP(clk_c_enable_104), .CD(clk_c_enable_58), 
            .CK(clk_c), .Q(tick_counter[13])) /* synthesis syn_use_carry_chain=1 */ ;   // C:/lscc/diamond/3.14/ispfpga/vhdl_packages/numeric_std.vhd(1241[12:13])
    defparam tick_counter_433__i13.GSR = "ENABLED";
    FD1P3IX tick_counter_433__i14 (.D(n69[14]), .SP(clk_c_enable_104), .CD(clk_c_enable_58), 
            .CK(clk_c), .Q(tick_counter[14])) /* synthesis syn_use_carry_chain=1 */ ;   // C:/lscc/diamond/3.14/ispfpga/vhdl_packages/numeric_std.vhd(1241[12:13])
    defparam tick_counter_433__i14.GSR = "ENABLED";
    FD1P3IX tick_counter_433__i15 (.D(n69[15]), .SP(clk_c_enable_104), .CD(clk_c_enable_58), 
            .CK(clk_c), .Q(tick_counter[15])) /* synthesis syn_use_carry_chain=1 */ ;   // C:/lscc/diamond/3.14/ispfpga/vhdl_packages/numeric_std.vhd(1241[12:13])
    defparam tick_counter_433__i15.GSR = "ENABLED";
    ORCALUT4 i4218_4_lut_4_lut (.A(n6154), .B(n11), .C(n10), .D(n4), 
            .Z(n12)) /* synthesis lut_function=(A (C)+!A (B (D)+!B (C))) */ ;   // c:/users/staig/documents/uni/master/signalgenerator/fpga_signalgenerator/code_loesung/saegezahn_gen.vhd(45[28:50])
    defparam i4218_4_lut_4_lut.init = 16'hf4b0;
    CCU2B tick_counter_433_add_4_17 (.A0(tick_counter[15]), .B0(GND_net), 
          .C0(GND_net), .D0(VCC_net), .A1(GND_net), .B1(GND_net), .C1(GND_net), 
          .D1(GND_net), .CIN(n4701), .S0(n69[15]));   // C:/lscc/diamond/3.14/ispfpga/vhdl_packages/numeric_std.vhd(1241[12:13])
    defparam tick_counter_433_add_4_17.INIT0 = 16'haaa0;
    defparam tick_counter_433_add_4_17.INIT1 = 16'h0000;
    defparam tick_counter_433_add_4_17.INJECT1_0 = "NO";
    defparam tick_counter_433_add_4_17.INJECT1_1 = "NO";
    CCU2B tick_counter_433_add_4_15 (.A0(tick_counter[13]), .B0(GND_net), 
          .C0(GND_net), .D0(VCC_net), .A1(tick_counter[14]), .B1(GND_net), 
          .C1(GND_net), .D1(VCC_net), .CIN(n4700), .COUT(n4701), .S0(n69[13]), 
          .S1(n69[14]));   // C:/lscc/diamond/3.14/ispfpga/vhdl_packages/numeric_std.vhd(1241[12:13])
    defparam tick_counter_433_add_4_15.INIT0 = 16'haaa0;
    defparam tick_counter_433_add_4_15.INIT1 = 16'haaa0;
    defparam tick_counter_433_add_4_15.INJECT1_0 = "NO";
    defparam tick_counter_433_add_4_15.INJECT1_1 = "NO";
    CCU2B tick_counter_433_add_4_13 (.A0(tick_counter[11]), .B0(GND_net), 
          .C0(GND_net), .D0(VCC_net), .A1(tick_counter[12]), .B1(GND_net), 
          .C1(GND_net), .D1(VCC_net), .CIN(n4699), .COUT(n4700), .S0(n69[11]), 
          .S1(n69[12]));   // C:/lscc/diamond/3.14/ispfpga/vhdl_packages/numeric_std.vhd(1241[12:13])
    defparam tick_counter_433_add_4_13.INIT0 = 16'haaa0;
    defparam tick_counter_433_add_4_13.INIT1 = 16'haaa0;
    defparam tick_counter_433_add_4_13.INJECT1_0 = "NO";
    defparam tick_counter_433_add_4_13.INJECT1_1 = "NO";
    CCU2B tick_counter_433_add_4_11 (.A0(tick_counter[9]), .B0(GND_net), 
          .C0(GND_net), .D0(VCC_net), .A1(tick_counter[10]), .B1(GND_net), 
          .C1(GND_net), .D1(VCC_net), .CIN(n4698), .COUT(n4699), .S0(n69[9]), 
          .S1(n69[10]));   // C:/lscc/diamond/3.14/ispfpga/vhdl_packages/numeric_std.vhd(1241[12:13])
    defparam tick_counter_433_add_4_11.INIT0 = 16'haaa0;
    defparam tick_counter_433_add_4_11.INIT1 = 16'haaa0;
    defparam tick_counter_433_add_4_11.INJECT1_0 = "NO";
    defparam tick_counter_433_add_4_11.INJECT1_1 = "NO";
    PFUMX LessThan_8_i14 (.BLUT(n8), .ALUT(n12), .C0(n5851), .Z(n14)) /* synthesis LSE_LINE_FILE_ID=20, LSE_LCOL=15, LSE_RCOL=40, LSE_LLINE=201, LSE_RLINE=201 */ ;
    CCU2B tick_counter_433_add_4_9 (.A0(tick_counter[7]), .B0(GND_net), 
          .C0(GND_net), .D0(VCC_net), .A1(tick_counter[8]), .B1(GND_net), 
          .C1(GND_net), .D1(VCC_net), .CIN(n4697), .COUT(n4698), .S0(n69[7]), 
          .S1(n69[8]));   // C:/lscc/diamond/3.14/ispfpga/vhdl_packages/numeric_std.vhd(1241[12:13])
    defparam tick_counter_433_add_4_9.INIT0 = 16'haaa0;
    defparam tick_counter_433_add_4_9.INIT1 = 16'haaa0;
    defparam tick_counter_433_add_4_9.INJECT1_0 = "NO";
    defparam tick_counter_433_add_4_9.INJECT1_1 = "NO";
    CCU2B tick_counter_433_add_4_7 (.A0(tick_counter[5]), .B0(GND_net), 
          .C0(GND_net), .D0(VCC_net), .A1(tick_counter[6]), .B1(GND_net), 
          .C1(GND_net), .D1(VCC_net), .CIN(n4696), .COUT(n4697), .S0(n69[5]), 
          .S1(n69[6]));   // C:/lscc/diamond/3.14/ispfpga/vhdl_packages/numeric_std.vhd(1241[12:13])
    defparam tick_counter_433_add_4_7.INIT0 = 16'haaa0;
    defparam tick_counter_433_add_4_7.INIT1 = 16'haaa0;
    defparam tick_counter_433_add_4_7.INJECT1_0 = "NO";
    defparam tick_counter_433_add_4_7.INJECT1_1 = "NO";
    CCU2B tick_counter_433_add_4_5 (.A0(tick_counter[3]), .B0(GND_net), 
          .C0(GND_net), .D0(VCC_net), .A1(tick_counter[4]), .B1(GND_net), 
          .C1(GND_net), .D1(VCC_net), .CIN(n4695), .COUT(n4696), .S0(n69[3]), 
          .S1(n69[4]));   // C:/lscc/diamond/3.14/ispfpga/vhdl_packages/numeric_std.vhd(1241[12:13])
    defparam tick_counter_433_add_4_5.INIT0 = 16'haaa0;
    defparam tick_counter_433_add_4_5.INIT1 = 16'haaa0;
    defparam tick_counter_433_add_4_5.INJECT1_0 = "NO";
    defparam tick_counter_433_add_4_5.INJECT1_1 = "NO";
    CCU2B tick_counter_433_add_4_3 (.A0(tick_counter[1]), .B0(GND_net), 
          .C0(GND_net), .D0(VCC_net), .A1(tick_counter[2]), .B1(GND_net), 
          .C1(GND_net), .D1(VCC_net), .CIN(n4694), .COUT(n4695), .S0(n69[1]), 
          .S1(n69[2]));   // C:/lscc/diamond/3.14/ispfpga/vhdl_packages/numeric_std.vhd(1241[12:13])
    defparam tick_counter_433_add_4_3.INIT0 = 16'haaa0;
    defparam tick_counter_433_add_4_3.INIT1 = 16'haaa0;
    defparam tick_counter_433_add_4_3.INJECT1_0 = "NO";
    defparam tick_counter_433_add_4_3.INJECT1_1 = "NO";
    ORCALUT4 i1_3_lut_4_lut_adj_54 (.A(wave_saw[2]), .B(n6156), .C(n6), 
            .D(wave_saw[3]), .Z(n5602)) /* synthesis lut_function=(!(A (B ((D)+!C)+!B !(C (D)))+!A !(C (D)))) */ ;   // C:/lscc/diamond/3.14/ispfpga/vhdl_packages/numeric_std.vhd(1241[12:13])
    defparam i1_3_lut_4_lut_adj_54.init = 16'h7080;
    CCU2B add_812_add_4_4 (.A0(tick_counter[1]), .B0(sig_p1[1]), .C0(GND_net), 
          .D0(VCC_net), .A1(tick_counter[2]), .B1(sig_p1[2]), .C1(GND_net), 
          .D1(VCC_net), .CIN(n4581), .COUT(n4582));
    defparam add_812_add_4_4.INIT0 = 16'h999a;
    defparam add_812_add_4_4.INIT1 = 16'h999a;
    defparam add_812_add_4_4.INJECT1_0 = "NO";
    defparam add_812_add_4_4.INJECT1_1 = "NO";
    CCU2B add_812_add_4_10 (.A0(tick_counter[7]), .B0(sig_p1[7]), .C0(GND_net), 
          .D0(VCC_net), .A1(tick_counter[8]), .B1(sig_p1[8]), .C1(GND_net), 
          .D1(VCC_net), .CIN(n4584), .COUT(n4585));
    defparam add_812_add_4_10.INIT0 = 16'h999a;
    defparam add_812_add_4_10.INIT1 = 16'h999a;
    defparam add_812_add_4_10.INJECT1_0 = "NO";
    defparam add_812_add_4_10.INJECT1_1 = "NO";
    CCU2B add_812_add_4_2 (.A0(GND_net), .B0(GND_net), .C0(GND_net), .D0(VCC_net), 
          .A1(tick_counter[0]), .B1(sig_p1[0]), .C1(GND_net), .D1(VCC_net), 
          .COUT(n4581));
    defparam add_812_add_4_2.INIT0 = 16'h000f;
    defparam add_812_add_4_2.INIT1 = 16'h999a;
    defparam add_812_add_4_2.INJECT1_0 = "NO";
    defparam add_812_add_4_2.INJECT1_1 = "NO";
    CCU2B add_812_add_4_16 (.A0(tick_counter[13]), .B0(sig_p1[13]), .C0(GND_net), 
          .D0(VCC_net), .A1(tick_counter[14]), .B1(sig_p1[14]), .C1(GND_net), 
          .D1(VCC_net), .CIN(n4587), .COUT(n4588));
    defparam add_812_add_4_16.INIT0 = 16'h999a;
    defparam add_812_add_4_16.INIT1 = 16'h999a;
    defparam add_812_add_4_16.INJECT1_0 = "NO";
    defparam add_812_add_4_16.INJECT1_1 = "NO";
    CCU2B add_812_add_4_12 (.A0(tick_counter[9]), .B0(sig_p1[9]), .C0(GND_net), 
          .D0(VCC_net), .A1(tick_counter[10]), .B1(sig_p1[10]), .C1(GND_net), 
          .D1(VCC_net), .CIN(n4585), .COUT(n4586));
    defparam add_812_add_4_12.INIT0 = 16'h999a;
    defparam add_812_add_4_12.INIT1 = 16'h999a;
    defparam add_812_add_4_12.INJECT1_0 = "NO";
    defparam add_812_add_4_12.INJECT1_1 = "NO";
    CCU2B add_812_add_4_8 (.A0(tick_counter[5]), .B0(sig_p1[5]), .C0(GND_net), 
          .D0(VCC_net), .A1(tick_counter[6]), .B1(sig_p1[6]), .C1(GND_net), 
          .D1(VCC_net), .CIN(n4583), .COUT(n4584));
    defparam add_812_add_4_8.INIT0 = 16'h999a;
    defparam add_812_add_4_8.INIT1 = 16'h999a;
    defparam add_812_add_4_8.INJECT1_0 = "NO";
    defparam add_812_add_4_8.INJECT1_1 = "NO";
    ORCALUT4 LessThan_8_i13_2_lut_rep_78 (.A(\sig_amp[7] ), .B(wave_saw[6]), 
            .Z(n6154)) /* synthesis lut_function=(!(A (B)+!A !(B))) */ ;   // c:/users/staig/documents/uni/master/signalgenerator/fpga_signalgenerator/code_loesung/saegezahn_gen.vhd(45[28:50])
    defparam LessThan_8_i13_2_lut_rep_78.init = 16'h6666;
    ORCALUT4 LessThan_8_i10_3_lut_3_lut (.A(\sig_amp[7] ), .B(wave_saw[6]), 
            .C(wave_saw[5]), .Z(n10)) /* synthesis lut_function=(A (B (C))+!A (B+(C))) */ ;   // c:/users/staig/documents/uni/master/signalgenerator/fpga_signalgenerator/code_loesung/saegezahn_gen.vhd(45[28:50])
    defparam LessThan_8_i10_3_lut_3_lut.init = 16'hd4d4;
    CCU2B tick_counter_433_add_4_1 (.A0(GND_net), .B0(GND_net), .C0(GND_net), 
          .D0(GND_net), .A1(tick_counter[0]), .B1(GND_net), .C1(GND_net), 
          .D1(VCC_net), .COUT(n4694), .S1(n69[0]));   // C:/lscc/diamond/3.14/ispfpga/vhdl_packages/numeric_std.vhd(1241[12:13])
    defparam tick_counter_433_add_4_1.INIT0 = 16'h0000;
    defparam tick_counter_433_add_4_1.INIT1 = 16'h555f;
    defparam tick_counter_433_add_4_1.INJECT1_0 = "NO";
    defparam tick_counter_433_add_4_1.INJECT1_1 = "NO";
    ORCALUT4 LessThan_8_i6_3_lut_3_lut (.A(\sig_amp[4] ), .B(wave_saw[3]), 
            .C(wave_saw[2]), .Z(n6_adj_665)) /* synthesis lut_function=(A (B (C))+!A (B+(C))) */ ;   // c:/users/staig/documents/uni/master/signalgenerator/fpga_signalgenerator/code_loesung/saegezahn_gen.vhd(45[28:50])
    defparam LessThan_8_i6_3_lut_3_lut.init = 16'hd4d4;
    FD1P3IX tick_counter_433__i0 (.D(n69[0]), .SP(clk_c_enable_104), .CD(clk_c_enable_58), 
            .CK(clk_c), .Q(tick_counter[0])) /* synthesis syn_use_carry_chain=1 */ ;   // C:/lscc/diamond/3.14/ispfpga/vhdl_packages/numeric_std.vhd(1241[12:13])
    defparam tick_counter_433__i0.GSR = "ENABLED";
    ORCALUT4 i4130_3_lut_4_lut (.A(\sig_amp[4] ), .B(wave_saw[3]), .C(wave_saw[2]), 
            .D(\sig_amp[3] ), .Z(n5842)) /* synthesis lut_function=(A (B (C (D)+!C !(D)))+!A !(B+!(C (D)+!C !(D)))) */ ;   // c:/users/staig/documents/uni/master/signalgenerator/fpga_signalgenerator/code_loesung/saegezahn_gen.vhd(45[28:50])
    defparam i4130_3_lut_4_lut.init = 16'h9009;
    ORCALUT4 LessThan_8_i9_2_lut_rep_79 (.A(\sig_amp[5] ), .B(wave_saw[4]), 
            .Z(n6155)) /* synthesis lut_function=(!(A (B)+!A !(B))) */ ;   // c:/users/staig/documents/uni/master/signalgenerator/fpga_signalgenerator/code_loesung/saegezahn_gen.vhd(45[28:50])
    defparam LessThan_8_i9_2_lut_rep_79.init = 16'h6666;
    ORCALUT4 LessThan_8_i8_3_lut_3_lut (.A(\sig_amp[5] ), .B(wave_saw[4]), 
            .C(n6_adj_665), .Z(n8)) /* synthesis lut_function=(A (B (C))+!A (B+(C))) */ ;   // c:/users/staig/documents/uni/master/signalgenerator/fpga_signalgenerator/code_loesung/saegezahn_gen.vhd(45[28:50])
    defparam LessThan_8_i8_3_lut_3_lut.init = 16'hd4d4;
    ORCALUT4 i1_3_lut_4_lut_adj_55 (.A(wave_saw[3]), .B(n6135), .C(n6), 
            .D(wave_saw[4]), .Z(n5604)) /* synthesis lut_function=(!(A (B ((D)+!C)+!B !(C (D)))+!A !(C (D)))) */ ;   // C:/lscc/diamond/3.14/ispfpga/vhdl_packages/numeric_std.vhd(1241[12:13])
    defparam i1_3_lut_4_lut_adj_55.init = 16'h7080;
    ORCALUT4 i675_2_lut_rep_80 (.A(wave_saw[1]), .B(wave_saw[0]), .Z(n6156)) /* synthesis lut_function=(A (B)) */ ;   // C:/lscc/diamond/3.14/ispfpga/vhdl_packages/numeric_std.vhd(1241[12:13])
    defparam i675_2_lut_rep_80.init = 16'h8888;
    ORCALUT4 i682_2_lut_rep_59_3_lut (.A(wave_saw[1]), .B(wave_saw[0]), 
            .C(wave_saw[2]), .Z(n6135)) /* synthesis lut_function=(A (B (C))) */ ;   // C:/lscc/diamond/3.14/ispfpga/vhdl_packages/numeric_std.vhd(1241[12:13])
    defparam i682_2_lut_rep_59_3_lut.init = 16'h8080;
    ORCALUT4 i2006_2_lut (.A(n6), .B(n6310), .Z(clk_c_enable_58)) /* synthesis lut_function=(A (B)) */ ;
    defparam i2006_2_lut.init = 16'h8888;
    ORCALUT4 i1_3_lut_4_lut_adj_56 (.A(wave_saw[1]), .B(wave_saw[0]), .C(wave_saw[2]), 
            .D(n6), .Z(n5598)) /* synthesis lut_function=(!(A (B (C+!(D))+!B !(C (D)))+!A !(C (D)))) */ ;   // C:/lscc/diamond/3.14/ispfpga/vhdl_packages/numeric_std.vhd(1241[12:13])
    defparam i1_3_lut_4_lut_adj_56.init = 16'h7800;
    ORCALUT4 i689_2_lut_rep_56_3_lut_4_lut (.A(wave_saw[1]), .B(wave_saw[0]), 
            .C(wave_saw[3]), .D(wave_saw[2]), .Z(n6132)) /* synthesis lut_function=(A (B (C (D)))) */ ;   // C:/lscc/diamond/3.14/ispfpga/vhdl_packages/numeric_std.vhd(1241[12:13])
    defparam i689_2_lut_rep_56_3_lut_4_lut.init = 16'h8000;
    ORCALUT4 mux_15_i1_4_lut (.A(n5610), .B(\sig_amp[1] ), .C(n675), .D(n7), 
            .Z(out_8bit_7__N_506[0])) /* synthesis lut_function=(!(A (B+!(C))+!A (B (C+(D))+!B !(C+!(D))))) */ ;   // c:/users/staig/documents/uni/master/signalgenerator/fpga_signalgenerator/code_loesung/saegezahn_gen.vhd(40[17] 60[24])
    defparam mux_15_i1_4_lut.init = 16'h3035;
    ORCALUT4 i1_2_lut (.A(n6), .B(wave_saw[0]), .Z(n5610)) /* synthesis lut_function=((B)+!A) */ ;   // c:/users/staig/documents/uni/master/signalgenerator/fpga_signalgenerator/code_loesung/saegezahn_gen.vhd(42[21] 53[28])
    defparam i1_2_lut.init = 16'hdddd;
    ORCALUT4 i1_3_lut_adj_57 (.A(n6), .B(n14), .C(wave_saw[7]), .Z(n675)) /* synthesis lut_function=(A (B (C))) */ ;
    defparam i1_3_lut_adj_57.init = 16'h8080;
    ORCALUT4 i861_2_lut (.A(n14), .B(wave_saw[7]), .Z(n7)) /* synthesis lut_function=(A (B)) */ ;
    defparam i861_2_lut.init = 16'h8888;
    ORCALUT4 i696_2_lut_rep_51_3_lut_4_lut (.A(wave_saw[2]), .B(n6156), 
            .C(wave_saw[4]), .D(wave_saw[3]), .Z(n6127)) /* synthesis lut_function=(A (B (C (D)))) */ ;   // C:/lscc/diamond/3.14/ispfpga/vhdl_packages/numeric_std.vhd(1241[12:13])
    defparam i696_2_lut_rep_51_3_lut_4_lut.init = 16'h8000;
    
endmodule
//
// Verilog Description of module frequenzteiler
//

module frequenzteiler (sig_p2, GND_net, VCC_net, tick_en, clk_c, clk_c_enable_104, 
            n6310);
    input [15:0]sig_p2;
    input GND_net;
    input VCC_net;
    output tick_en;
    input clk_c;
    output clk_c_enable_104;
    output n6310;
    
    wire clk_c /* synthesis SET_AS_NETWORK=clk_c, is_clock=1 */ ;   // c:/users/staig/documents/uni/master/signalgenerator/fpga_signalgenerator/code_loesung/toplevel.vhd(20[9:12])
    
    wire n4604;
    wire [16:0]counter_15__N_323;
    
    wire n4605, n4603, counter_15__N_322, n4602, n4601, n4600, n4731;
    wire [15:0]counter;   // c:/users/staig/documents/uni/master/signalgenerator/fpga_signalgenerator/code_loesung/frequenzteiler.vhd(24[12:19])
    wire [15:0]n69;
    
    wire n4599, n4730, n4729, n4728, n4727, n4726, n4725, n4724, 
        n4639, n4638, n4637, n4636, n4635, n4634, n4633, n4632, 
        n4606;
    
    CCU2B add_17_add_4_13 (.A0(sig_p2[11]), .B0(GND_net), .C0(GND_net), 
          .D0(VCC_net), .A1(sig_p2[12]), .B1(GND_net), .C1(GND_net), 
          .D1(VCC_net), .CIN(n4604), .COUT(n4605), .S0(counter_15__N_323[11]), 
          .S1(counter_15__N_323[12]));   // C:/lscc/diamond/3.14/ispfpga/vhdl_packages/numeric_std.vhd(1308[12:13])
    defparam add_17_add_4_13.INIT0 = 16'h555a;
    defparam add_17_add_4_13.INIT1 = 16'h555a;
    defparam add_17_add_4_13.INJECT1_0 = "NO";
    defparam add_17_add_4_13.INJECT1_1 = "NO";
    CCU2B add_17_add_4_11 (.A0(sig_p2[9]), .B0(GND_net), .C0(GND_net), 
          .D0(VCC_net), .A1(sig_p2[10]), .B1(GND_net), .C1(GND_net), 
          .D1(VCC_net), .CIN(n4603), .COUT(n4604), .S0(counter_15__N_323[9]), 
          .S1(counter_15__N_323[10]));   // C:/lscc/diamond/3.14/ispfpga/vhdl_packages/numeric_std.vhd(1308[12:13])
    defparam add_17_add_4_11.INIT0 = 16'h555a;
    defparam add_17_add_4_11.INIT1 = 16'h555a;
    defparam add_17_add_4_11.INJECT1_0 = "NO";
    defparam add_17_add_4_11.INJECT1_1 = "NO";
    FD1S3AX tick_reg_15 (.D(counter_15__N_322), .CK(clk_c), .Q(tick_en)) /* synthesis lse_init_val=0, LSE_LINE_FILE_ID=20, LSE_LCOL=23, LSE_RCOL=49, LSE_LLINE=163, LSE_RLINE=163 */ ;   // c:/users/staig/documents/uni/master/signalgenerator/fpga_signalgenerator/code_loesung/frequenzteiler.vhd(30[9] 38[16])
    defparam tick_reg_15.GSR = "ENABLED";
    CCU2B add_17_add_4_9 (.A0(sig_p2[7]), .B0(GND_net), .C0(GND_net), 
          .D0(VCC_net), .A1(sig_p2[8]), .B1(GND_net), .C1(GND_net), 
          .D1(VCC_net), .CIN(n4602), .COUT(n4603), .S0(counter_15__N_323[7]), 
          .S1(counter_15__N_323[8]));   // C:/lscc/diamond/3.14/ispfpga/vhdl_packages/numeric_std.vhd(1308[12:13])
    defparam add_17_add_4_9.INIT0 = 16'h555a;
    defparam add_17_add_4_9.INIT1 = 16'h555a;
    defparam add_17_add_4_9.INJECT1_0 = "NO";
    defparam add_17_add_4_9.INJECT1_1 = "NO";
    CCU2B add_17_add_4_7 (.A0(sig_p2[5]), .B0(GND_net), .C0(GND_net), 
          .D0(VCC_net), .A1(sig_p2[6]), .B1(GND_net), .C1(GND_net), 
          .D1(VCC_net), .CIN(n4601), .COUT(n4602), .S0(counter_15__N_323[5]), 
          .S1(counter_15__N_323[6]));   // C:/lscc/diamond/3.14/ispfpga/vhdl_packages/numeric_std.vhd(1308[12:13])
    defparam add_17_add_4_7.INIT0 = 16'h555a;
    defparam add_17_add_4_7.INIT1 = 16'h555a;
    defparam add_17_add_4_7.INJECT1_0 = "NO";
    defparam add_17_add_4_7.INJECT1_1 = "NO";
    CCU2B add_17_add_4_5 (.A0(sig_p2[3]), .B0(GND_net), .C0(GND_net), 
          .D0(VCC_net), .A1(sig_p2[4]), .B1(GND_net), .C1(GND_net), 
          .D1(VCC_net), .CIN(n4600), .COUT(n4601), .S0(counter_15__N_323[3]), 
          .S1(counter_15__N_323[4]));   // C:/lscc/diamond/3.14/ispfpga/vhdl_packages/numeric_std.vhd(1308[12:13])
    defparam add_17_add_4_5.INIT0 = 16'h555a;
    defparam add_17_add_4_5.INIT1 = 16'h555a;
    defparam add_17_add_4_5.INJECT1_0 = "NO";
    defparam add_17_add_4_5.INJECT1_1 = "NO";
    CCU2B counter_429_add_4_17 (.A0(counter[15]), .B0(GND_net), .C0(GND_net), 
          .D0(VCC_net), .A1(GND_net), .B1(GND_net), .C1(GND_net), .D1(GND_net), 
          .CIN(n4731), .S0(n69[15]));   // C:/lscc/diamond/3.14/ispfpga/vhdl_packages/numeric_std.vhd(1241[12:13])
    defparam counter_429_add_4_17.INIT0 = 16'haaa0;
    defparam counter_429_add_4_17.INIT1 = 16'h0000;
    defparam counter_429_add_4_17.INJECT1_0 = "NO";
    defparam counter_429_add_4_17.INJECT1_1 = "NO";
    CCU2B add_17_add_4_3 (.A0(sig_p2[1]), .B0(GND_net), .C0(GND_net), 
          .D0(VCC_net), .A1(sig_p2[2]), .B1(GND_net), .C1(GND_net), 
          .D1(VCC_net), .CIN(n4599), .COUT(n4600), .S0(counter_15__N_323[1]), 
          .S1(counter_15__N_323[2]));   // C:/lscc/diamond/3.14/ispfpga/vhdl_packages/numeric_std.vhd(1308[12:13])
    defparam add_17_add_4_3.INIT0 = 16'h555a;
    defparam add_17_add_4_3.INIT1 = 16'h555a;
    defparam add_17_add_4_3.INJECT1_0 = "NO";
    defparam add_17_add_4_3.INJECT1_1 = "NO";
    CCU2B counter_429_add_4_15 (.A0(counter[13]), .B0(GND_net), .C0(GND_net), 
          .D0(VCC_net), .A1(counter[14]), .B1(GND_net), .C1(GND_net), 
          .D1(VCC_net), .CIN(n4730), .COUT(n4731), .S0(n69[13]), .S1(n69[14]));   // C:/lscc/diamond/3.14/ispfpga/vhdl_packages/numeric_std.vhd(1241[12:13])
    defparam counter_429_add_4_15.INIT0 = 16'haaa0;
    defparam counter_429_add_4_15.INIT1 = 16'haaa0;
    defparam counter_429_add_4_15.INJECT1_0 = "NO";
    defparam counter_429_add_4_15.INJECT1_1 = "NO";
    CCU2B counter_429_add_4_13 (.A0(counter[11]), .B0(GND_net), .C0(GND_net), 
          .D0(VCC_net), .A1(counter[12]), .B1(GND_net), .C1(GND_net), 
          .D1(VCC_net), .CIN(n4729), .COUT(n4730), .S0(n69[11]), .S1(n69[12]));   // C:/lscc/diamond/3.14/ispfpga/vhdl_packages/numeric_std.vhd(1241[12:13])
    defparam counter_429_add_4_13.INIT0 = 16'haaa0;
    defparam counter_429_add_4_13.INIT1 = 16'haaa0;
    defparam counter_429_add_4_13.INJECT1_0 = "NO";
    defparam counter_429_add_4_13.INJECT1_1 = "NO";
    CCU2B counter_429_add_4_11 (.A0(counter[9]), .B0(GND_net), .C0(GND_net), 
          .D0(VCC_net), .A1(counter[10]), .B1(GND_net), .C1(GND_net), 
          .D1(VCC_net), .CIN(n4728), .COUT(n4729), .S0(n69[9]), .S1(n69[10]));   // C:/lscc/diamond/3.14/ispfpga/vhdl_packages/numeric_std.vhd(1241[12:13])
    defparam counter_429_add_4_11.INIT0 = 16'haaa0;
    defparam counter_429_add_4_11.INIT1 = 16'haaa0;
    defparam counter_429_add_4_11.INJECT1_0 = "NO";
    defparam counter_429_add_4_11.INJECT1_1 = "NO";
    CCU2B counter_429_add_4_9 (.A0(counter[7]), .B0(GND_net), .C0(GND_net), 
          .D0(VCC_net), .A1(counter[8]), .B1(GND_net), .C1(GND_net), 
          .D1(VCC_net), .CIN(n4727), .COUT(n4728), .S0(n69[7]), .S1(n69[8]));   // C:/lscc/diamond/3.14/ispfpga/vhdl_packages/numeric_std.vhd(1241[12:13])
    defparam counter_429_add_4_9.INIT0 = 16'haaa0;
    defparam counter_429_add_4_9.INIT1 = 16'haaa0;
    defparam counter_429_add_4_9.INJECT1_0 = "NO";
    defparam counter_429_add_4_9.INJECT1_1 = "NO";
    CCU2B counter_429_add_4_7 (.A0(counter[5]), .B0(GND_net), .C0(GND_net), 
          .D0(VCC_net), .A1(counter[6]), .B1(GND_net), .C1(GND_net), 
          .D1(VCC_net), .CIN(n4726), .COUT(n4727), .S0(n69[5]), .S1(n69[6]));   // C:/lscc/diamond/3.14/ispfpga/vhdl_packages/numeric_std.vhd(1241[12:13])
    defparam counter_429_add_4_7.INIT0 = 16'haaa0;
    defparam counter_429_add_4_7.INIT1 = 16'haaa0;
    defparam counter_429_add_4_7.INJECT1_0 = "NO";
    defparam counter_429_add_4_7.INJECT1_1 = "NO";
    CCU2B add_17_add_4_1 (.A0(GND_net), .B0(GND_net), .C0(GND_net), .D0(GND_net), 
          .A1(sig_p2[0]), .B1(GND_net), .C1(GND_net), .D1(VCC_net), 
          .COUT(n4599), .S1(counter_15__N_323[0]));   // C:/lscc/diamond/3.14/ispfpga/vhdl_packages/numeric_std.vhd(1308[12:13])
    defparam add_17_add_4_1.INIT0 = 16'h0000;
    defparam add_17_add_4_1.INIT1 = 16'h555a;
    defparam add_17_add_4_1.INJECT1_0 = "NO";
    defparam add_17_add_4_1.INJECT1_1 = "NO";
    CCU2B counter_429_add_4_5 (.A0(counter[3]), .B0(GND_net), .C0(GND_net), 
          .D0(VCC_net), .A1(counter[4]), .B1(GND_net), .C1(GND_net), 
          .D1(VCC_net), .CIN(n4725), .COUT(n4726), .S0(n69[3]), .S1(n69[4]));   // C:/lscc/diamond/3.14/ispfpga/vhdl_packages/numeric_std.vhd(1241[12:13])
    defparam counter_429_add_4_5.INIT0 = 16'haaa0;
    defparam counter_429_add_4_5.INIT1 = 16'haaa0;
    defparam counter_429_add_4_5.INJECT1_0 = "NO";
    defparam counter_429_add_4_5.INJECT1_1 = "NO";
    CCU2B counter_429_add_4_3 (.A0(counter[1]), .B0(GND_net), .C0(GND_net), 
          .D0(VCC_net), .A1(counter[2]), .B1(GND_net), .C1(GND_net), 
          .D1(VCC_net), .CIN(n4724), .COUT(n4725), .S0(n69[1]), .S1(n69[2]));   // C:/lscc/diamond/3.14/ispfpga/vhdl_packages/numeric_std.vhd(1241[12:13])
    defparam counter_429_add_4_3.INIT0 = 16'haaa0;
    defparam counter_429_add_4_3.INIT1 = 16'haaa0;
    defparam counter_429_add_4_3.INJECT1_0 = "NO";
    defparam counter_429_add_4_3.INJECT1_1 = "NO";
    CCU2B counter_429_add_4_1 (.A0(GND_net), .B0(GND_net), .C0(GND_net), 
          .D0(GND_net), .A1(counter[0]), .B1(GND_net), .C1(GND_net), 
          .D1(VCC_net), .COUT(n4724), .S1(n69[0]));   // C:/lscc/diamond/3.14/ispfpga/vhdl_packages/numeric_std.vhd(1241[12:13])
    defparam counter_429_add_4_1.INIT0 = 16'h0000;
    defparam counter_429_add_4_1.INIT1 = 16'h555f;
    defparam counter_429_add_4_1.INJECT1_0 = "NO";
    defparam counter_429_add_4_1.INJECT1_1 = "NO";
    FD1S3IX counter_429__i0 (.D(n69[0]), .CK(clk_c), .CD(counter_15__N_322), 
            .Q(counter[0])) /* synthesis syn_use_carry_chain=1 */ ;   // C:/lscc/diamond/3.14/ispfpga/vhdl_packages/numeric_std.vhd(1241[12:13])
    defparam counter_429__i0.GSR = "ENABLED";
    CCU2B add_813_add_4_18 (.A0(counter[15]), .B0(counter_15__N_323[15]), 
          .C0(GND_net), .D0(VCC_net), .A1(GND_net), .B1(GND_net), .C1(GND_net), 
          .D1(GND_net), .CIN(n4639), .S1(counter_15__N_322));
    defparam add_813_add_4_18.INIT0 = 16'h999a;
    defparam add_813_add_4_18.INIT1 = 16'h0000;
    defparam add_813_add_4_18.INJECT1_0 = "NO";
    defparam add_813_add_4_18.INJECT1_1 = "NO";
    FD1S3IX counter_429__i1 (.D(n69[1]), .CK(clk_c), .CD(counter_15__N_322), 
            .Q(counter[1])) /* synthesis syn_use_carry_chain=1 */ ;   // C:/lscc/diamond/3.14/ispfpga/vhdl_packages/numeric_std.vhd(1241[12:13])
    defparam counter_429__i1.GSR = "ENABLED";
    CCU2B add_813_add_4_16 (.A0(counter[13]), .B0(counter_15__N_323[13]), 
          .C0(GND_net), .D0(VCC_net), .A1(counter[14]), .B1(counter_15__N_323[14]), 
          .C1(GND_net), .D1(VCC_net), .CIN(n4638), .COUT(n4639));
    defparam add_813_add_4_16.INIT0 = 16'h999a;
    defparam add_813_add_4_16.INIT1 = 16'h999a;
    defparam add_813_add_4_16.INJECT1_0 = "NO";
    defparam add_813_add_4_16.INJECT1_1 = "NO";
    CCU2B add_813_add_4_14 (.A0(counter[11]), .B0(counter_15__N_323[11]), 
          .C0(GND_net), .D0(VCC_net), .A1(counter[12]), .B1(counter_15__N_323[12]), 
          .C1(GND_net), .D1(VCC_net), .CIN(n4637), .COUT(n4638));
    defparam add_813_add_4_14.INIT0 = 16'h999a;
    defparam add_813_add_4_14.INIT1 = 16'h999a;
    defparam add_813_add_4_14.INJECT1_0 = "NO";
    defparam add_813_add_4_14.INJECT1_1 = "NO";
    FD1S3IX counter_429__i2 (.D(n69[2]), .CK(clk_c), .CD(counter_15__N_322), 
            .Q(counter[2])) /* synthesis syn_use_carry_chain=1 */ ;   // C:/lscc/diamond/3.14/ispfpga/vhdl_packages/numeric_std.vhd(1241[12:13])
    defparam counter_429__i2.GSR = "ENABLED";
    FD1S3IX counter_429__i3 (.D(n69[3]), .CK(clk_c), .CD(counter_15__N_322), 
            .Q(counter[3])) /* synthesis syn_use_carry_chain=1 */ ;   // C:/lscc/diamond/3.14/ispfpga/vhdl_packages/numeric_std.vhd(1241[12:13])
    defparam counter_429__i3.GSR = "ENABLED";
    FD1S3IX counter_429__i4 (.D(n69[4]), .CK(clk_c), .CD(counter_15__N_322), 
            .Q(counter[4])) /* synthesis syn_use_carry_chain=1 */ ;   // C:/lscc/diamond/3.14/ispfpga/vhdl_packages/numeric_std.vhd(1241[12:13])
    defparam counter_429__i4.GSR = "ENABLED";
    FD1S3IX counter_429__i5 (.D(n69[5]), .CK(clk_c), .CD(counter_15__N_322), 
            .Q(counter[5])) /* synthesis syn_use_carry_chain=1 */ ;   // C:/lscc/diamond/3.14/ispfpga/vhdl_packages/numeric_std.vhd(1241[12:13])
    defparam counter_429__i5.GSR = "ENABLED";
    FD1S3IX counter_429__i6 (.D(n69[6]), .CK(clk_c), .CD(counter_15__N_322), 
            .Q(counter[6])) /* synthesis syn_use_carry_chain=1 */ ;   // C:/lscc/diamond/3.14/ispfpga/vhdl_packages/numeric_std.vhd(1241[12:13])
    defparam counter_429__i6.GSR = "ENABLED";
    FD1S3IX counter_429__i7 (.D(n69[7]), .CK(clk_c), .CD(counter_15__N_322), 
            .Q(counter[7])) /* synthesis syn_use_carry_chain=1 */ ;   // C:/lscc/diamond/3.14/ispfpga/vhdl_packages/numeric_std.vhd(1241[12:13])
    defparam counter_429__i7.GSR = "ENABLED";
    FD1S3IX counter_429__i8 (.D(n69[8]), .CK(clk_c), .CD(counter_15__N_322), 
            .Q(counter[8])) /* synthesis syn_use_carry_chain=1 */ ;   // C:/lscc/diamond/3.14/ispfpga/vhdl_packages/numeric_std.vhd(1241[12:13])
    defparam counter_429__i8.GSR = "ENABLED";
    FD1S3IX counter_429__i9 (.D(n69[9]), .CK(clk_c), .CD(counter_15__N_322), 
            .Q(counter[9])) /* synthesis syn_use_carry_chain=1 */ ;   // C:/lscc/diamond/3.14/ispfpga/vhdl_packages/numeric_std.vhd(1241[12:13])
    defparam counter_429__i9.GSR = "ENABLED";
    FD1S3IX counter_429__i10 (.D(n69[10]), .CK(clk_c), .CD(counter_15__N_322), 
            .Q(counter[10])) /* synthesis syn_use_carry_chain=1 */ ;   // C:/lscc/diamond/3.14/ispfpga/vhdl_packages/numeric_std.vhd(1241[12:13])
    defparam counter_429__i10.GSR = "ENABLED";
    FD1S3IX counter_429__i11 (.D(n69[11]), .CK(clk_c), .CD(counter_15__N_322), 
            .Q(counter[11])) /* synthesis syn_use_carry_chain=1 */ ;   // C:/lscc/diamond/3.14/ispfpga/vhdl_packages/numeric_std.vhd(1241[12:13])
    defparam counter_429__i11.GSR = "ENABLED";
    FD1S3IX counter_429__i12 (.D(n69[12]), .CK(clk_c), .CD(counter_15__N_322), 
            .Q(counter[12])) /* synthesis syn_use_carry_chain=1 */ ;   // C:/lscc/diamond/3.14/ispfpga/vhdl_packages/numeric_std.vhd(1241[12:13])
    defparam counter_429__i12.GSR = "ENABLED";
    FD1S3IX counter_429__i13 (.D(n69[13]), .CK(clk_c), .CD(counter_15__N_322), 
            .Q(counter[13])) /* synthesis syn_use_carry_chain=1 */ ;   // C:/lscc/diamond/3.14/ispfpga/vhdl_packages/numeric_std.vhd(1241[12:13])
    defparam counter_429__i13.GSR = "ENABLED";
    FD1S3IX counter_429__i14 (.D(n69[14]), .CK(clk_c), .CD(counter_15__N_322), 
            .Q(counter[14])) /* synthesis syn_use_carry_chain=1 */ ;   // C:/lscc/diamond/3.14/ispfpga/vhdl_packages/numeric_std.vhd(1241[12:13])
    defparam counter_429__i14.GSR = "ENABLED";
    FD1S3IX counter_429__i15 (.D(n69[15]), .CK(clk_c), .CD(counter_15__N_322), 
            .Q(counter[15])) /* synthesis syn_use_carry_chain=1 */ ;   // C:/lscc/diamond/3.14/ispfpga/vhdl_packages/numeric_std.vhd(1241[12:13])
    defparam counter_429__i15.GSR = "ENABLED";
    CCU2B add_813_add_4_12 (.A0(counter[9]), .B0(counter_15__N_323[9]), 
          .C0(GND_net), .D0(VCC_net), .A1(counter[10]), .B1(counter_15__N_323[10]), 
          .C1(GND_net), .D1(VCC_net), .CIN(n4636), .COUT(n4637));
    defparam add_813_add_4_12.INIT0 = 16'h999a;
    defparam add_813_add_4_12.INIT1 = 16'h999a;
    defparam add_813_add_4_12.INJECT1_0 = "NO";
    defparam add_813_add_4_12.INJECT1_1 = "NO";
    CCU2B add_813_add_4_10 (.A0(counter[7]), .B0(counter_15__N_323[7]), 
          .C0(GND_net), .D0(VCC_net), .A1(counter[8]), .B1(counter_15__N_323[8]), 
          .C1(GND_net), .D1(VCC_net), .CIN(n4635), .COUT(n4636));
    defparam add_813_add_4_10.INIT0 = 16'h999a;
    defparam add_813_add_4_10.INIT1 = 16'h999a;
    defparam add_813_add_4_10.INJECT1_0 = "NO";
    defparam add_813_add_4_10.INJECT1_1 = "NO";
    CCU2B add_813_add_4_8 (.A0(counter[5]), .B0(counter_15__N_323[5]), .C0(GND_net), 
          .D0(VCC_net), .A1(counter[6]), .B1(counter_15__N_323[6]), .C1(GND_net), 
          .D1(VCC_net), .CIN(n4634), .COUT(n4635));
    defparam add_813_add_4_8.INIT0 = 16'h999a;
    defparam add_813_add_4_8.INIT1 = 16'h999a;
    defparam add_813_add_4_8.INJECT1_0 = "NO";
    defparam add_813_add_4_8.INJECT1_1 = "NO";
    CCU2B add_813_add_4_6 (.A0(counter[3]), .B0(counter_15__N_323[3]), .C0(GND_net), 
          .D0(VCC_net), .A1(counter[4]), .B1(counter_15__N_323[4]), .C1(GND_net), 
          .D1(VCC_net), .CIN(n4633), .COUT(n4634));
    defparam add_813_add_4_6.INIT0 = 16'h999a;
    defparam add_813_add_4_6.INIT1 = 16'h999a;
    defparam add_813_add_4_6.INJECT1_0 = "NO";
    defparam add_813_add_4_6.INJECT1_1 = "NO";
    CCU2B add_813_add_4_4 (.A0(counter[1]), .B0(counter_15__N_323[1]), .C0(GND_net), 
          .D0(VCC_net), .A1(counter[2]), .B1(counter_15__N_323[2]), .C1(GND_net), 
          .D1(VCC_net), .CIN(n4632), .COUT(n4633));
    defparam add_813_add_4_4.INIT0 = 16'h999a;
    defparam add_813_add_4_4.INIT1 = 16'h999a;
    defparam add_813_add_4_4.INJECT1_0 = "NO";
    defparam add_813_add_4_4.INJECT1_1 = "NO";
    CCU2B add_17_add_4_17 (.A0(sig_p2[15]), .B0(GND_net), .C0(GND_net), 
          .D0(VCC_net), .A1(GND_net), .B1(GND_net), .C1(GND_net), .D1(GND_net), 
          .CIN(n4606), .S0(counter_15__N_323[15]));   // C:/lscc/diamond/3.14/ispfpga/vhdl_packages/numeric_std.vhd(1308[12:13])
    defparam add_17_add_4_17.INIT0 = 16'h555a;
    defparam add_17_add_4_17.INIT1 = 16'h0000;
    defparam add_17_add_4_17.INJECT1_0 = "NO";
    defparam add_17_add_4_17.INJECT1_1 = "NO";
    CCU2B add_813_add_4_2 (.A0(GND_net), .B0(GND_net), .C0(GND_net), .D0(VCC_net), 
          .A1(counter[0]), .B1(counter_15__N_323[0]), .C1(GND_net), .D1(VCC_net), 
          .COUT(n4632));
    defparam add_813_add_4_2.INIT0 = 16'h000f;
    defparam add_813_add_4_2.INIT1 = 16'h999a;
    defparam add_813_add_4_2.INJECT1_0 = "NO";
    defparam add_813_add_4_2.INJECT1_1 = "NO";
    CCU2B add_17_add_4_15 (.A0(sig_p2[13]), .B0(GND_net), .C0(GND_net), 
          .D0(VCC_net), .A1(sig_p2[14]), .B1(GND_net), .C1(GND_net), 
          .D1(VCC_net), .CIN(n4605), .COUT(n4606), .S0(counter_15__N_323[13]), 
          .S1(counter_15__N_323[14]));   // C:/lscc/diamond/3.14/ispfpga/vhdl_packages/numeric_std.vhd(1308[12:13])
    defparam add_17_add_4_15.INIT0 = 16'h555a;
    defparam add_17_add_4_15.INIT1 = 16'h555a;
    defparam add_17_add_4_15.INJECT1_0 = "NO";
    defparam add_17_add_4_15.INJECT1_1 = "NO";
    FD1S3AX tick_reg_15_rep_83 (.D(counter_15__N_322), .CK(clk_c), .Q(clk_c_enable_104)) /* synthesis lse_init_val=0, LSE_LINE_FILE_ID=20, LSE_LCOL=23, LSE_RCOL=49, LSE_LLINE=163, LSE_RLINE=163 */ ;   // c:/users/staig/documents/uni/master/signalgenerator/fpga_signalgenerator/code_loesung/frequenzteiler.vhd(30[9] 38[16])
    defparam tick_reg_15_rep_83.GSR = "ENABLED";
    FD1S3AX tick_reg_15_rep_82 (.D(counter_15__N_322), .CK(clk_c), .Q(n6310)) /* synthesis lse_init_val=0, LSE_LINE_FILE_ID=20, LSE_LCOL=23, LSE_RCOL=49, LSE_LLINE=163, LSE_RLINE=163 */ ;   // c:/users/staig/documents/uni/master/signalgenerator/fpga_signalgenerator/code_loesung/frequenzteiler.vhd(30[9] 38[16])
    defparam tick_reg_15_rep_82.GSR = "ENABLED";
    
endmodule
//
// Verilog Description of module dreieck_gen
//

module dreieck_gen (sig_p1, GND_net, VCC_net, wave_tri, \sig_amp[6] , 
            is_rising, \sig_amp[2] , \sig_amp[1] , clk_c, n5789, clk_c_enable_104, 
            \sig_amp[7] , \sig_amp[4] , \sig_amp[3] , n3648, \sig_amp[5] , 
            n14, n6310);
    input [15:0]sig_p1;
    input GND_net;
    input VCC_net;
    output [7:0]wave_tri;
    input \sig_amp[6] ;
    output is_rising;
    input \sig_amp[2] ;
    input \sig_amp[1] ;
    input clk_c;
    input n5789;
    input clk_c_enable_104;
    input \sig_amp[7] ;
    input \sig_amp[4] ;
    input \sig_amp[3] ;
    output n3648;
    input \sig_amp[5] ;
    output n14;
    input n6310;
    
    wire clk_c /* synthesis SET_AS_NETWORK=clk_c, is_clock=1 */ ;   // c:/users/staig/documents/uni/master/signalgenerator/fpga_signalgenerator/code_loesung/toplevel.vhd(20[9:12])
    
    wire n4630;
    wire [15:0]tick_counter;   // c:/users/staig/documents/uni/master/signalgenerator/fpga_signalgenerator/code_loesung/dreieck_gen.vhd(34[12:24])
    
    wire n4631, n4629, n2760, n6152, n6153, n5827, n5836, n4628, 
        n6150, n11, n10, n4, n12, n4735, is_rising_N_428, n3652;
    wire [7:0]n37;
    
    wire n4734, n4627, n6151, n5813, n5822, n4626, n4733, n4732, 
        n4625, n3638, n3644, n3646, n4624, clk_c_enable_103, n4715;
    wire [15:0]n69;
    
    wire n4714, n4713, n4712, n4711, n4710, n4709, n4708, n6, 
        n3642, n8, n3640, is_rising_N_429;
    
    CCU2B add_814_add_4_16 (.A0(tick_counter[13]), .B0(sig_p1[13]), .C0(GND_net), 
          .D0(VCC_net), .A1(tick_counter[14]), .B1(sig_p1[14]), .C1(GND_net), 
          .D1(VCC_net), .CIN(n4630), .COUT(n4631));
    defparam add_814_add_4_16.INIT0 = 16'h999a;
    defparam add_814_add_4_16.INIT1 = 16'h999a;
    defparam add_814_add_4_16.INJECT1_0 = "NO";
    defparam add_814_add_4_16.INJECT1_1 = "NO";
    CCU2B add_814_add_4_14 (.A0(tick_counter[11]), .B0(sig_p1[11]), .C0(GND_net), 
          .D0(VCC_net), .A1(tick_counter[12]), .B1(sig_p1[12]), .C1(GND_net), 
          .D1(VCC_net), .CIN(n4629), .COUT(n4630));
    defparam add_814_add_4_14.INIT0 = 16'h999a;
    defparam add_814_add_4_14.INIT1 = 16'h999a;
    defparam add_814_add_4_14.INJECT1_0 = "NO";
    defparam add_814_add_4_14.INJECT1_1 = "NO";
    ORCALUT4 i1_2_lut (.A(wave_tri[5]), .B(\sig_amp[6] ), .Z(n2760)) /* synthesis lut_function=(!(A (B)+!A !(B))) */ ;
    defparam i1_2_lut.init = 16'h6666;
    ORCALUT4 i4257_4_lut (.A(n6152), .B(n2760), .C(n6153), .D(n5827), 
            .Z(n5836)) /* synthesis lut_function=(((C (D))+!B)+!A) */ ;   // c:/users/staig/documents/uni/master/signalgenerator/fpga_signalgenerator/code_loesung/dreieck_gen.vhd(58[28:50])
    defparam i4257_4_lut.init = 16'hf777;
    CCU2B add_814_add_4_12 (.A0(tick_counter[9]), .B0(sig_p1[9]), .C0(GND_net), 
          .D0(VCC_net), .A1(tick_counter[10]), .B1(sig_p1[10]), .C1(GND_net), 
          .D1(VCC_net), .CIN(n4628), .COUT(n4629));
    defparam add_814_add_4_12.INIT0 = 16'h999a;
    defparam add_814_add_4_12.INIT1 = 16'h999a;
    defparam add_814_add_4_12.INJECT1_0 = "NO";
    defparam add_814_add_4_12.INJECT1_1 = "NO";
    ORCALUT4 i4214_4_lut_4_lut (.A(n6150), .B(n11), .C(n10), .D(n4), 
            .Z(n12)) /* synthesis lut_function=(A (C)+!A (B (D)+!B (C))) */ ;   // c:/users/staig/documents/uni/master/signalgenerator/fpga_signalgenerator/code_loesung/dreieck_gen.vhd(50[28:50])
    defparam i4214_4_lut_4_lut.init = 16'hf4b0;
    CCU2B current_val_428_add_4_9 (.A0(wave_tri[7]), .B0(is_rising), .C0(is_rising_N_428), 
          .D0(n3652), .A1(GND_net), .B1(GND_net), .C1(GND_net), .D1(GND_net), 
          .CIN(n4735), .S0(n37[7]));   // c:/users/staig/documents/uni/master/signalgenerator/fpga_signalgenerator/code_loesung/dreieck_gen.vhd(46[17] 69[24])
    defparam current_val_428_add_4_9.INIT0 = 16'h596a;
    defparam current_val_428_add_4_9.INIT1 = 16'h0000;
    defparam current_val_428_add_4_9.INJECT1_0 = "NO";
    defparam current_val_428_add_4_9.INJECT1_1 = "NO";
    CCU2B current_val_428_add_4_7 (.A0(wave_tri[5]), .B0(is_rising), .C0(is_rising_N_428), 
          .D0(n3652), .A1(wave_tri[6]), .B1(is_rising), .C1(is_rising_N_428), 
          .D1(n3652), .CIN(n4734), .COUT(n4735), .S0(n37[5]), .S1(n37[6]));   // c:/users/staig/documents/uni/master/signalgenerator/fpga_signalgenerator/code_loesung/dreieck_gen.vhd(46[17] 69[24])
    defparam current_val_428_add_4_7.INIT0 = 16'h596a;
    defparam current_val_428_add_4_7.INIT1 = 16'h596a;
    defparam current_val_428_add_4_7.INJECT1_0 = "NO";
    defparam current_val_428_add_4_7.INJECT1_1 = "NO";
    CCU2B add_814_add_4_10 (.A0(tick_counter[7]), .B0(sig_p1[7]), .C0(GND_net), 
          .D0(VCC_net), .A1(tick_counter[8]), .B1(sig_p1[8]), .C1(GND_net), 
          .D1(VCC_net), .CIN(n4627), .COUT(n4628));
    defparam add_814_add_4_10.INIT0 = 16'h999a;
    defparam add_814_add_4_10.INIT1 = 16'h999a;
    defparam add_814_add_4_10.INJECT1_0 = "NO";
    defparam add_814_add_4_10.INJECT1_1 = "NO";
    ORCALUT4 max_val_7__I_0_i11_2_lut (.A(\sig_amp[6] ), .B(wave_tri[5]), 
            .Z(n11)) /* synthesis lut_function=(A (B)+!A !(B)) */ ;   // c:/users/staig/documents/uni/master/signalgenerator/fpga_signalgenerator/code_loesung/dreieck_gen.vhd(50[28:50])
    defparam max_val_7__I_0_i11_2_lut.init = 16'h9999;
    ORCALUT4 i4262_4_lut (.A(n6150), .B(n11), .C(n6151), .D(n5813), 
            .Z(n5822)) /* synthesis lut_function=(A+!(B (C+!(D)))) */ ;   // c:/users/staig/documents/uni/master/signalgenerator/fpga_signalgenerator/code_loesung/dreieck_gen.vhd(50[28:50])
    defparam i4262_4_lut.init = 16'hbfbb;
    CCU2B add_814_add_4_8 (.A0(tick_counter[5]), .B0(sig_p1[5]), .C0(GND_net), 
          .D0(VCC_net), .A1(tick_counter[6]), .B1(sig_p1[6]), .C1(GND_net), 
          .D1(VCC_net), .CIN(n4626), .COUT(n4627));
    defparam add_814_add_4_8.INIT0 = 16'h999a;
    defparam add_814_add_4_8.INIT1 = 16'h999a;
    defparam add_814_add_4_8.INJECT1_0 = "NO";
    defparam add_814_add_4_8.INJECT1_1 = "NO";
    CCU2B current_val_428_add_4_5 (.A0(wave_tri[3]), .B0(is_rising), .C0(is_rising_N_428), 
          .D0(n3652), .A1(wave_tri[4]), .B1(is_rising), .C1(is_rising_N_428), 
          .D1(n3652), .CIN(n4733), .COUT(n4734), .S0(n37[3]), .S1(n37[4]));   // c:/users/staig/documents/uni/master/signalgenerator/fpga_signalgenerator/code_loesung/dreieck_gen.vhd(46[17] 69[24])
    defparam current_val_428_add_4_5.INIT0 = 16'h596a;
    defparam current_val_428_add_4_5.INIT1 = 16'h596a;
    defparam current_val_428_add_4_5.INJECT1_0 = "NO";
    defparam current_val_428_add_4_5.INJECT1_1 = "NO";
    CCU2B current_val_428_add_4_3 (.A0(wave_tri[1]), .B0(is_rising), .C0(is_rising_N_428), 
          .D0(n3652), .A1(wave_tri[2]), .B1(is_rising), .C1(is_rising_N_428), 
          .D1(n3652), .CIN(n4732), .COUT(n4733), .S0(n37[1]), .S1(n37[2]));   // c:/users/staig/documents/uni/master/signalgenerator/fpga_signalgenerator/code_loesung/dreieck_gen.vhd(46[17] 69[24])
    defparam current_val_428_add_4_3.INIT0 = 16'h596a;
    defparam current_val_428_add_4_3.INIT1 = 16'h596a;
    defparam current_val_428_add_4_3.INJECT1_0 = "NO";
    defparam current_val_428_add_4_3.INJECT1_1 = "NO";
    CCU2B current_val_428_add_4_1 (.A0(GND_net), .B0(GND_net), .C0(GND_net), 
          .D0(GND_net), .A1(wave_tri[0]), .B1(GND_net), .C1(GND_net), 
          .D1(VCC_net), .COUT(n4732), .S1(n37[0]));   // c:/users/staig/documents/uni/master/signalgenerator/fpga_signalgenerator/code_loesung/dreieck_gen.vhd(46[17] 69[24])
    defparam current_val_428_add_4_1.INIT0 = 16'h0000;
    defparam current_val_428_add_4_1.INIT1 = 16'h555f;
    defparam current_val_428_add_4_1.INJECT1_0 = "NO";
    defparam current_val_428_add_4_1.INJECT1_1 = "NO";
    CCU2B add_814_add_4_6 (.A0(tick_counter[3]), .B0(sig_p1[3]), .C0(GND_net), 
          .D0(VCC_net), .A1(tick_counter[4]), .B1(sig_p1[4]), .C1(GND_net), 
          .D1(VCC_net), .CIN(n4625), .COUT(n4626));
    defparam add_814_add_4_6.INIT0 = 16'h999a;
    defparam add_814_add_4_6.INIT1 = 16'h999a;
    defparam add_814_add_4_6.INJECT1_0 = "NO";
    defparam add_814_add_4_6.INJECT1_1 = "NO";
    ORCALUT4 max_val_7__I_0_i4_4_lut (.A(wave_tri[0]), .B(wave_tri[1]), 
            .C(\sig_amp[2] ), .D(\sig_amp[1] ), .Z(n4)) /* synthesis lut_function=(A (B+!(C))+!A !(B (C (D))+!B (C+(D)))) */ ;   // c:/users/staig/documents/uni/master/signalgenerator/fpga_signalgenerator/code_loesung/dreieck_gen.vhd(50[28:50])
    defparam max_val_7__I_0_i4_4_lut.init = 16'h8ecf;
    ORCALUT4 out_8bit_7__I_0_i4_4_lut (.A(\sig_amp[2] ), .B(\sig_amp[1] ), 
            .C(wave_tri[1]), .D(wave_tri[0]), .Z(n3638)) /* synthesis lut_function=(A (B (C+(D))+!B (C))+!A (B (C (D)))) */ ;   // c:/users/staig/documents/uni/master/signalgenerator/fpga_signalgenerator/code_loesung/dreieck_gen.vhd(58[28:50])
    defparam out_8bit_7__I_0_i4_4_lut.init = 16'he8a0;
    ORCALUT4 i4216_4_lut (.A(n3638), .B(n3644), .C(n6152), .D(n2760), 
            .Z(n3646)) /* synthesis lut_function=(A (B+(C (D)))+!A !((C (D))+!B)) */ ;   // c:/users/staig/documents/uni/master/signalgenerator/fpga_signalgenerator/code_loesung/dreieck_gen.vhd(58[28:50])
    defparam i4216_4_lut.init = 16'haccc;
    CCU2B add_814_add_4_4 (.A0(tick_counter[1]), .B0(sig_p1[1]), .C0(GND_net), 
          .D0(VCC_net), .A1(tick_counter[2]), .B1(sig_p1[2]), .C1(GND_net), 
          .D1(VCC_net), .CIN(n4624), .COUT(n4625));
    defparam add_814_add_4_4.INIT0 = 16'h999a;
    defparam add_814_add_4_4.INIT1 = 16'h999a;
    defparam add_814_add_4_4.INJECT1_0 = "NO";
    defparam add_814_add_4_4.INJECT1_1 = "NO";
    CCU2B add_814_add_4_2 (.A0(GND_net), .B0(GND_net), .C0(GND_net), .D0(VCC_net), 
          .A1(tick_counter[0]), .B1(sig_p1[0]), .C1(GND_net), .D1(VCC_net), 
          .COUT(n4624));
    defparam add_814_add_4_2.INIT0 = 16'h000f;
    defparam add_814_add_4_2.INIT1 = 16'h999a;
    defparam add_814_add_4_2.INJECT1_0 = "NO";
    defparam add_814_add_4_2.INJECT1_1 = "NO";
    FD1P3AX current_val_428__i0 (.D(n37[0]), .SP(clk_c_enable_103), .CK(clk_c), 
            .Q(wave_tri[0])) /* synthesis syn_use_carry_chain=1 */ ;   // c:/users/staig/documents/uni/master/signalgenerator/fpga_signalgenerator/code_loesung/dreieck_gen.vhd(46[17] 69[24])
    defparam current_val_428__i0.GSR = "ENABLED";
    CCU2B tick_counter_431_add_4_17 (.A0(tick_counter[15]), .B0(GND_net), 
          .C0(GND_net), .D0(VCC_net), .A1(GND_net), .B1(GND_net), .C1(GND_net), 
          .D1(GND_net), .CIN(n4715), .S0(n69[15]));   // C:/lscc/diamond/3.14/ispfpga/vhdl_packages/numeric_std.vhd(1241[12:13])
    defparam tick_counter_431_add_4_17.INIT0 = 16'haaa0;
    defparam tick_counter_431_add_4_17.INIT1 = 16'h0000;
    defparam tick_counter_431_add_4_17.INJECT1_0 = "NO";
    defparam tick_counter_431_add_4_17.INJECT1_1 = "NO";
    CCU2B tick_counter_431_add_4_15 (.A0(tick_counter[13]), .B0(GND_net), 
          .C0(GND_net), .D0(VCC_net), .A1(tick_counter[14]), .B1(GND_net), 
          .C1(GND_net), .D1(VCC_net), .CIN(n4714), .COUT(n4715), .S0(n69[13]), 
          .S1(n69[14]));   // C:/lscc/diamond/3.14/ispfpga/vhdl_packages/numeric_std.vhd(1241[12:13])
    defparam tick_counter_431_add_4_15.INIT0 = 16'haaa0;
    defparam tick_counter_431_add_4_15.INIT1 = 16'haaa0;
    defparam tick_counter_431_add_4_15.INJECT1_0 = "NO";
    defparam tick_counter_431_add_4_15.INJECT1_1 = "NO";
    CCU2B tick_counter_431_add_4_13 (.A0(tick_counter[11]), .B0(GND_net), 
          .C0(GND_net), .D0(VCC_net), .A1(tick_counter[12]), .B1(GND_net), 
          .C1(GND_net), .D1(VCC_net), .CIN(n4713), .COUT(n4714), .S0(n69[11]), 
          .S1(n69[12]));   // C:/lscc/diamond/3.14/ispfpga/vhdl_packages/numeric_std.vhd(1241[12:13])
    defparam tick_counter_431_add_4_13.INIT0 = 16'haaa0;
    defparam tick_counter_431_add_4_13.INIT1 = 16'haaa0;
    defparam tick_counter_431_add_4_13.INJECT1_0 = "NO";
    defparam tick_counter_431_add_4_13.INJECT1_1 = "NO";
    CCU2B tick_counter_431_add_4_11 (.A0(tick_counter[9]), .B0(GND_net), 
          .C0(GND_net), .D0(VCC_net), .A1(tick_counter[10]), .B1(GND_net), 
          .C1(GND_net), .D1(VCC_net), .CIN(n4712), .COUT(n4713), .S0(n69[9]), 
          .S1(n69[10]));   // C:/lscc/diamond/3.14/ispfpga/vhdl_packages/numeric_std.vhd(1241[12:13])
    defparam tick_counter_431_add_4_11.INIT0 = 16'haaa0;
    defparam tick_counter_431_add_4_11.INIT1 = 16'haaa0;
    defparam tick_counter_431_add_4_11.INJECT1_0 = "NO";
    defparam tick_counter_431_add_4_11.INJECT1_1 = "NO";
    CCU2B tick_counter_431_add_4_9 (.A0(tick_counter[7]), .B0(GND_net), 
          .C0(GND_net), .D0(VCC_net), .A1(tick_counter[8]), .B1(GND_net), 
          .C1(GND_net), .D1(VCC_net), .CIN(n4711), .COUT(n4712), .S0(n69[7]), 
          .S1(n69[8]));   // C:/lscc/diamond/3.14/ispfpga/vhdl_packages/numeric_std.vhd(1241[12:13])
    defparam tick_counter_431_add_4_9.INIT0 = 16'haaa0;
    defparam tick_counter_431_add_4_9.INIT1 = 16'haaa0;
    defparam tick_counter_431_add_4_9.INJECT1_0 = "NO";
    defparam tick_counter_431_add_4_9.INJECT1_1 = "NO";
    CCU2B tick_counter_431_add_4_7 (.A0(tick_counter[5]), .B0(GND_net), 
          .C0(GND_net), .D0(VCC_net), .A1(tick_counter[6]), .B1(GND_net), 
          .C1(GND_net), .D1(VCC_net), .CIN(n4710), .COUT(n4711), .S0(n69[5]), 
          .S1(n69[6]));   // C:/lscc/diamond/3.14/ispfpga/vhdl_packages/numeric_std.vhd(1241[12:13])
    defparam tick_counter_431_add_4_7.INIT0 = 16'haaa0;
    defparam tick_counter_431_add_4_7.INIT1 = 16'haaa0;
    defparam tick_counter_431_add_4_7.INJECT1_0 = "NO";
    defparam tick_counter_431_add_4_7.INJECT1_1 = "NO";
    CCU2B tick_counter_431_add_4_5 (.A0(tick_counter[3]), .B0(GND_net), 
          .C0(GND_net), .D0(VCC_net), .A1(tick_counter[4]), .B1(GND_net), 
          .C1(GND_net), .D1(VCC_net), .CIN(n4709), .COUT(n4710), .S0(n69[3]), 
          .S1(n69[4]));   // C:/lscc/diamond/3.14/ispfpga/vhdl_packages/numeric_std.vhd(1241[12:13])
    defparam tick_counter_431_add_4_5.INIT0 = 16'haaa0;
    defparam tick_counter_431_add_4_5.INIT1 = 16'haaa0;
    defparam tick_counter_431_add_4_5.INJECT1_0 = "NO";
    defparam tick_counter_431_add_4_5.INJECT1_1 = "NO";
    CCU2B tick_counter_431_add_4_3 (.A0(tick_counter[1]), .B0(GND_net), 
          .C0(GND_net), .D0(VCC_net), .A1(tick_counter[2]), .B1(GND_net), 
          .C1(GND_net), .D1(VCC_net), .CIN(n4708), .COUT(n4709), .S0(n69[1]), 
          .S1(n69[2]));   // C:/lscc/diamond/3.14/ispfpga/vhdl_packages/numeric_std.vhd(1241[12:13])
    defparam tick_counter_431_add_4_3.INIT0 = 16'haaa0;
    defparam tick_counter_431_add_4_3.INIT1 = 16'haaa0;
    defparam tick_counter_431_add_4_3.INJECT1_0 = "NO";
    defparam tick_counter_431_add_4_3.INJECT1_1 = "NO";
    CCU2B tick_counter_431_add_4_1 (.A0(GND_net), .B0(GND_net), .C0(GND_net), 
          .D0(GND_net), .A1(tick_counter[0]), .B1(GND_net), .C1(GND_net), 
          .D1(VCC_net), .COUT(n4708), .S1(n69[0]));   // C:/lscc/diamond/3.14/ispfpga/vhdl_packages/numeric_std.vhd(1241[12:13])
    defparam tick_counter_431_add_4_1.INIT0 = 16'h0000;
    defparam tick_counter_431_add_4_1.INIT1 = 16'h555f;
    defparam tick_counter_431_add_4_1.INJECT1_0 = "NO";
    defparam tick_counter_431_add_4_1.INJECT1_1 = "NO";
    FD1P3AY is_rising_34 (.D(n5789), .SP(clk_c_enable_103), .CK(clk_c), 
            .Q(is_rising)) /* synthesis lse_init_val=1, LSE_LINE_FILE_ID=20, LSE_LCOL=15, LSE_RCOL=38, LSE_LLINE=181, LSE_RLINE=181 */ ;   // c:/users/staig/documents/uni/master/signalgenerator/fpga_signalgenerator/code_loesung/dreieck_gen.vhd(43[9] 72[16])
    defparam is_rising_34.GSR = "ENABLED";
    FD1P3IX tick_counter_431__i1 (.D(n69[1]), .SP(clk_c_enable_104), .CD(clk_c_enable_103), 
            .CK(clk_c), .Q(tick_counter[1])) /* synthesis syn_use_carry_chain=1 */ ;   // C:/lscc/diamond/3.14/ispfpga/vhdl_packages/numeric_std.vhd(1241[12:13])
    defparam tick_counter_431__i1.GSR = "ENABLED";
    FD1P3IX tick_counter_431__i2 (.D(n69[2]), .SP(clk_c_enable_104), .CD(clk_c_enable_103), 
            .CK(clk_c), .Q(tick_counter[2])) /* synthesis syn_use_carry_chain=1 */ ;   // C:/lscc/diamond/3.14/ispfpga/vhdl_packages/numeric_std.vhd(1241[12:13])
    defparam tick_counter_431__i2.GSR = "ENABLED";
    ORCALUT4 max_val_7__I_0_i13_2_lut_rep_74 (.A(\sig_amp[7] ), .B(wave_tri[6]), 
            .Z(n6150)) /* synthesis lut_function=(!(A (B)+!A !(B))) */ ;   // c:/users/staig/documents/uni/master/signalgenerator/fpga_signalgenerator/code_loesung/dreieck_gen.vhd(50[28:50])
    defparam max_val_7__I_0_i13_2_lut_rep_74.init = 16'h6666;
    ORCALUT4 max_val_7__I_0_i10_3_lut_3_lut (.A(\sig_amp[7] ), .B(wave_tri[6]), 
            .C(wave_tri[5]), .Z(n10)) /* synthesis lut_function=(A (B (C))+!A (B+(C))) */ ;   // c:/users/staig/documents/uni/master/signalgenerator/fpga_signalgenerator/code_loesung/dreieck_gen.vhd(50[28:50])
    defparam max_val_7__I_0_i10_3_lut_3_lut.init = 16'hd4d4;
    ORCALUT4 max_val_7__I_0_i6_3_lut_3_lut (.A(\sig_amp[4] ), .B(wave_tri[3]), 
            .C(wave_tri[2]), .Z(n6)) /* synthesis lut_function=(A (B (C))+!A (B+(C))) */ ;   // c:/users/staig/documents/uni/master/signalgenerator/fpga_signalgenerator/code_loesung/dreieck_gen.vhd(50[28:50])
    defparam max_val_7__I_0_i6_3_lut_3_lut.init = 16'hd4d4;
    ORCALUT4 i4101_3_lut_4_lut (.A(\sig_amp[4] ), .B(wave_tri[3]), .C(wave_tri[2]), 
            .D(\sig_amp[3] ), .Z(n5813)) /* synthesis lut_function=(A (B (C (D)+!C !(D)))+!A !(B+!(C (D)+!C !(D)))) */ ;   // c:/users/staig/documents/uni/master/signalgenerator/fpga_signalgenerator/code_loesung/dreieck_gen.vhd(50[28:50])
    defparam i4101_3_lut_4_lut.init = 16'h9009;
    PFUMX out_8bit_7__I_0_i14 (.BLUT(n3642), .ALUT(n3646), .C0(n5836), 
          .Z(n3648)) /* synthesis LSE_LINE_FILE_ID=20, LSE_LCOL=15, LSE_RCOL=38, LSE_LLINE=181, LSE_RLINE=181 */ ;
    ORCALUT4 max_val_7__I_0_i9_2_lut_rep_75 (.A(\sig_amp[5] ), .B(wave_tri[4]), 
            .Z(n6151)) /* synthesis lut_function=(!(A (B)+!A !(B))) */ ;   // c:/users/staig/documents/uni/master/signalgenerator/fpga_signalgenerator/code_loesung/dreieck_gen.vhd(50[28:50])
    defparam max_val_7__I_0_i9_2_lut_rep_75.init = 16'h6666;
    ORCALUT4 max_val_7__I_0_i8_3_lut_3_lut (.A(\sig_amp[5] ), .B(wave_tri[4]), 
            .C(n6), .Z(n8)) /* synthesis lut_function=(A (B (C))+!A (B+(C))) */ ;   // c:/users/staig/documents/uni/master/signalgenerator/fpga_signalgenerator/code_loesung/dreieck_gen.vhd(50[28:50])
    defparam max_val_7__I_0_i8_3_lut_3_lut.init = 16'hd4d4;
    PFUMX max_val_7__I_0_i14 (.BLUT(n8), .ALUT(n12), .C0(n5822), .Z(n14)) /* synthesis LSE_LINE_FILE_ID=20, LSE_LCOL=15, LSE_RCOL=38, LSE_LLINE=181, LSE_RLINE=181 */ ;
    FD1P3IX tick_counter_431__i3 (.D(n69[3]), .SP(clk_c_enable_104), .CD(clk_c_enable_103), 
            .CK(clk_c), .Q(tick_counter[3])) /* synthesis syn_use_carry_chain=1 */ ;   // C:/lscc/diamond/3.14/ispfpga/vhdl_packages/numeric_std.vhd(1241[12:13])
    defparam tick_counter_431__i3.GSR = "ENABLED";
    ORCALUT4 i1_2_lut_rep_76 (.A(wave_tri[6]), .B(\sig_amp[7] ), .Z(n6152)) /* synthesis lut_function=(!(A (B)+!A !(B))) */ ;
    defparam i1_2_lut_rep_76.init = 16'h6666;
    ORCALUT4 out_8bit_7__I_0_i10_3_lut_3_lut (.A(wave_tri[6]), .B(\sig_amp[7] ), 
            .C(\sig_amp[6] ), .Z(n3644)) /* synthesis lut_function=(A (B+(C))+!A (B (C))) */ ;
    defparam out_8bit_7__I_0_i10_3_lut_3_lut.init = 16'he8e8;
    ORCALUT4 out_8bit_7__I_0_i6_3_lut_3_lut (.A(wave_tri[3]), .B(\sig_amp[4] ), 
            .C(\sig_amp[3] ), .Z(n3640)) /* synthesis lut_function=(A (B+(C))+!A (B (C))) */ ;
    defparam out_8bit_7__I_0_i6_3_lut_3_lut.init = 16'he8e8;
    ORCALUT4 i4115_3_lut_4_lut (.A(wave_tri[3]), .B(\sig_amp[4] ), .C(\sig_amp[3] ), 
            .D(wave_tri[2]), .Z(n5827)) /* synthesis lut_function=(!(A (B+(C (D)+!C !(D)))+!A ((C (D)+!C !(D))+!B))) */ ;
    defparam i4115_3_lut_4_lut.init = 16'h0660;
    FD1P3IX tick_counter_431__i4 (.D(n69[4]), .SP(clk_c_enable_104), .CD(clk_c_enable_103), 
            .CK(clk_c), .Q(tick_counter[4])) /* synthesis syn_use_carry_chain=1 */ ;   // C:/lscc/diamond/3.14/ispfpga/vhdl_packages/numeric_std.vhd(1241[12:13])
    defparam tick_counter_431__i4.GSR = "ENABLED";
    FD1P3IX tick_counter_431__i5 (.D(n69[5]), .SP(clk_c_enable_104), .CD(clk_c_enable_103), 
            .CK(clk_c), .Q(tick_counter[5])) /* synthesis syn_use_carry_chain=1 */ ;   // C:/lscc/diamond/3.14/ispfpga/vhdl_packages/numeric_std.vhd(1241[12:13])
    defparam tick_counter_431__i5.GSR = "ENABLED";
    FD1P3IX tick_counter_431__i6 (.D(n69[6]), .SP(clk_c_enable_104), .CD(clk_c_enable_103), 
            .CK(clk_c), .Q(tick_counter[6])) /* synthesis syn_use_carry_chain=1 */ ;   // C:/lscc/diamond/3.14/ispfpga/vhdl_packages/numeric_std.vhd(1241[12:13])
    defparam tick_counter_431__i6.GSR = "ENABLED";
    FD1P3IX tick_counter_431__i7 (.D(n69[7]), .SP(clk_c_enable_104), .CD(clk_c_enable_103), 
            .CK(clk_c), .Q(tick_counter[7])) /* synthesis syn_use_carry_chain=1 */ ;   // C:/lscc/diamond/3.14/ispfpga/vhdl_packages/numeric_std.vhd(1241[12:13])
    defparam tick_counter_431__i7.GSR = "ENABLED";
    FD1P3IX tick_counter_431__i8 (.D(n69[8]), .SP(clk_c_enable_104), .CD(clk_c_enable_103), 
            .CK(clk_c), .Q(tick_counter[8])) /* synthesis syn_use_carry_chain=1 */ ;   // C:/lscc/diamond/3.14/ispfpga/vhdl_packages/numeric_std.vhd(1241[12:13])
    defparam tick_counter_431__i8.GSR = "ENABLED";
    FD1P3IX tick_counter_431__i9 (.D(n69[9]), .SP(clk_c_enable_104), .CD(clk_c_enable_103), 
            .CK(clk_c), .Q(tick_counter[9])) /* synthesis syn_use_carry_chain=1 */ ;   // C:/lscc/diamond/3.14/ispfpga/vhdl_packages/numeric_std.vhd(1241[12:13])
    defparam tick_counter_431__i9.GSR = "ENABLED";
    FD1P3IX tick_counter_431__i10 (.D(n69[10]), .SP(clk_c_enable_104), .CD(clk_c_enable_103), 
            .CK(clk_c), .Q(tick_counter[10])) /* synthesis syn_use_carry_chain=1 */ ;   // C:/lscc/diamond/3.14/ispfpga/vhdl_packages/numeric_std.vhd(1241[12:13])
    defparam tick_counter_431__i10.GSR = "ENABLED";
    FD1P3IX tick_counter_431__i11 (.D(n69[11]), .SP(clk_c_enable_104), .CD(clk_c_enable_103), 
            .CK(clk_c), .Q(tick_counter[11])) /* synthesis syn_use_carry_chain=1 */ ;   // C:/lscc/diamond/3.14/ispfpga/vhdl_packages/numeric_std.vhd(1241[12:13])
    defparam tick_counter_431__i11.GSR = "ENABLED";
    FD1P3IX tick_counter_431__i12 (.D(n69[12]), .SP(clk_c_enable_104), .CD(clk_c_enable_103), 
            .CK(clk_c), .Q(tick_counter[12])) /* synthesis syn_use_carry_chain=1 */ ;   // C:/lscc/diamond/3.14/ispfpga/vhdl_packages/numeric_std.vhd(1241[12:13])
    defparam tick_counter_431__i12.GSR = "ENABLED";
    FD1P3IX tick_counter_431__i13 (.D(n69[13]), .SP(clk_c_enable_104), .CD(clk_c_enable_103), 
            .CK(clk_c), .Q(tick_counter[13])) /* synthesis syn_use_carry_chain=1 */ ;   // C:/lscc/diamond/3.14/ispfpga/vhdl_packages/numeric_std.vhd(1241[12:13])
    defparam tick_counter_431__i13.GSR = "ENABLED";
    FD1P3IX tick_counter_431__i14 (.D(n69[14]), .SP(clk_c_enable_104), .CD(clk_c_enable_103), 
            .CK(clk_c), .Q(tick_counter[14])) /* synthesis syn_use_carry_chain=1 */ ;   // C:/lscc/diamond/3.14/ispfpga/vhdl_packages/numeric_std.vhd(1241[12:13])
    defparam tick_counter_431__i14.GSR = "ENABLED";
    FD1P3IX tick_counter_431__i15 (.D(n69[15]), .SP(clk_c_enable_104), .CD(clk_c_enable_103), 
            .CK(clk_c), .Q(tick_counter[15])) /* synthesis syn_use_carry_chain=1 */ ;   // C:/lscc/diamond/3.14/ispfpga/vhdl_packages/numeric_std.vhd(1241[12:13])
    defparam tick_counter_431__i15.GSR = "ENABLED";
    ORCALUT4 i1_2_lut_rep_77 (.A(wave_tri[4]), .B(\sig_amp[5] ), .Z(n6153)) /* synthesis lut_function=(!(A (B)+!A !(B))) */ ;
    defparam i1_2_lut_rep_77.init = 16'h6666;
    ORCALUT4 out_8bit_7__I_0_i8_3_lut_3_lut (.A(wave_tri[4]), .B(\sig_amp[5] ), 
            .C(n3640), .Z(n3642)) /* synthesis lut_function=(A (B+(C))+!A (B (C))) */ ;
    defparam out_8bit_7__I_0_i8_3_lut_3_lut.init = 16'he8e8;
    FD1P3IX tick_counter_431__i0 (.D(n69[0]), .SP(clk_c_enable_104), .CD(clk_c_enable_103), 
            .CK(clk_c), .Q(tick_counter[0])) /* synthesis syn_use_carry_chain=1 */ ;   // C:/lscc/diamond/3.14/ispfpga/vhdl_packages/numeric_std.vhd(1241[12:13])
    defparam tick_counter_431__i0.GSR = "ENABLED";
    FD1P3AX current_val_428__i1 (.D(n37[1]), .SP(clk_c_enable_103), .CK(clk_c), 
            .Q(wave_tri[1])) /* synthesis syn_use_carry_chain=1 */ ;   // c:/users/staig/documents/uni/master/signalgenerator/fpga_signalgenerator/code_loesung/dreieck_gen.vhd(46[17] 69[24])
    defparam current_val_428__i1.GSR = "ENABLED";
    FD1P3AX current_val_428__i2 (.D(n37[2]), .SP(clk_c_enable_103), .CK(clk_c), 
            .Q(wave_tri[2])) /* synthesis syn_use_carry_chain=1 */ ;   // c:/users/staig/documents/uni/master/signalgenerator/fpga_signalgenerator/code_loesung/dreieck_gen.vhd(46[17] 69[24])
    defparam current_val_428__i2.GSR = "ENABLED";
    FD1P3AX current_val_428__i3 (.D(n37[3]), .SP(clk_c_enable_103), .CK(clk_c), 
            .Q(wave_tri[3])) /* synthesis syn_use_carry_chain=1 */ ;   // c:/users/staig/documents/uni/master/signalgenerator/fpga_signalgenerator/code_loesung/dreieck_gen.vhd(46[17] 69[24])
    defparam current_val_428__i3.GSR = "ENABLED";
    FD1P3AX current_val_428__i4 (.D(n37[4]), .SP(clk_c_enable_103), .CK(clk_c), 
            .Q(wave_tri[4])) /* synthesis syn_use_carry_chain=1 */ ;   // c:/users/staig/documents/uni/master/signalgenerator/fpga_signalgenerator/code_loesung/dreieck_gen.vhd(46[17] 69[24])
    defparam current_val_428__i4.GSR = "ENABLED";
    FD1P3AX current_val_428__i5 (.D(n37[5]), .SP(clk_c_enable_103), .CK(clk_c), 
            .Q(wave_tri[5])) /* synthesis syn_use_carry_chain=1 */ ;   // c:/users/staig/documents/uni/master/signalgenerator/fpga_signalgenerator/code_loesung/dreieck_gen.vhd(46[17] 69[24])
    defparam current_val_428__i5.GSR = "ENABLED";
    FD1P3AX current_val_428__i6 (.D(n37[6]), .SP(clk_c_enable_103), .CK(clk_c), 
            .Q(wave_tri[6])) /* synthesis syn_use_carry_chain=1 */ ;   // c:/users/staig/documents/uni/master/signalgenerator/fpga_signalgenerator/code_loesung/dreieck_gen.vhd(46[17] 69[24])
    defparam current_val_428__i6.GSR = "ENABLED";
    FD1P3AX current_val_428__i7 (.D(n37[7]), .SP(clk_c_enable_103), .CK(clk_c), 
            .Q(wave_tri[7])) /* synthesis syn_use_carry_chain=1 */ ;   // c:/users/staig/documents/uni/master/signalgenerator/fpga_signalgenerator/code_loesung/dreieck_gen.vhd(46[17] 69[24])
    defparam current_val_428__i7.GSR = "ENABLED";
    CCU2B add_814_add_4_18 (.A0(tick_counter[15]), .B0(sig_p1[15]), .C0(GND_net), 
          .D0(VCC_net), .A1(GND_net), .B1(GND_net), .C1(GND_net), .D1(GND_net), 
          .CIN(n4631), .S1(is_rising_N_429));
    defparam add_814_add_4_18.INIT0 = 16'h999a;
    defparam add_814_add_4_18.INIT1 = 16'h0000;
    defparam add_814_add_4_18.INJECT1_0 = "NO";
    defparam add_814_add_4_18.INJECT1_1 = "NO";
    ORCALUT4 i860_2_lut (.A(n14), .B(wave_tri[7]), .Z(is_rising_N_428)) /* synthesis lut_function=(A (B)) */ ;
    defparam i860_2_lut.init = 16'h8888;
    ORCALUT4 i2132_2_lut (.A(n3648), .B(wave_tri[7]), .Z(n3652)) /* synthesis lut_function=(A+(B)) */ ;
    defparam i2132_2_lut.init = 16'heeee;
    ORCALUT4 i1568_2_lut (.A(n6310), .B(is_rising_N_429), .Z(clk_c_enable_103)) /* synthesis lut_function=(A (B)) */ ;   // C:/lscc/diamond/3.14/ispfpga/vhdl_packages/numeric_std.vhd(1241[12:13])
    defparam i1568_2_lut.init = 16'h8888;
    
endmodule
//
// Verilog Description of module mystery
//
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
